cansat-tsniimash/NeonBlade-2024/README.md

# NeonBlade-2024
Это репозиторий команды Neon Blade
