cansat-tsniimash/NeonBlade-2024/docs/Зимняя сессия/Структурная схема.pdf

# Схема подключений

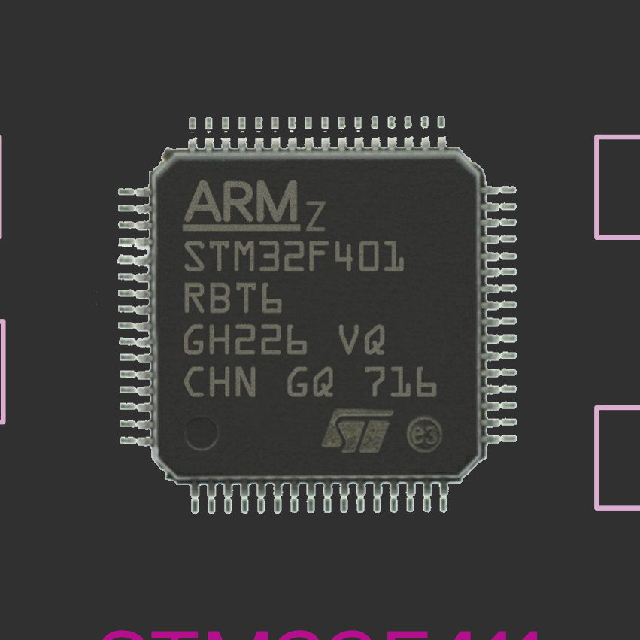
[picture p1: figure]

## STM32F411

SPI | SPI

BME280

LSM6DSL

LIS3MDL

## SPI

## SPI

ADC | UART
SDIO | SDIO

## GPIO

## ADC

ФОТОРЕЗИСТОР

GPIO | GPIO

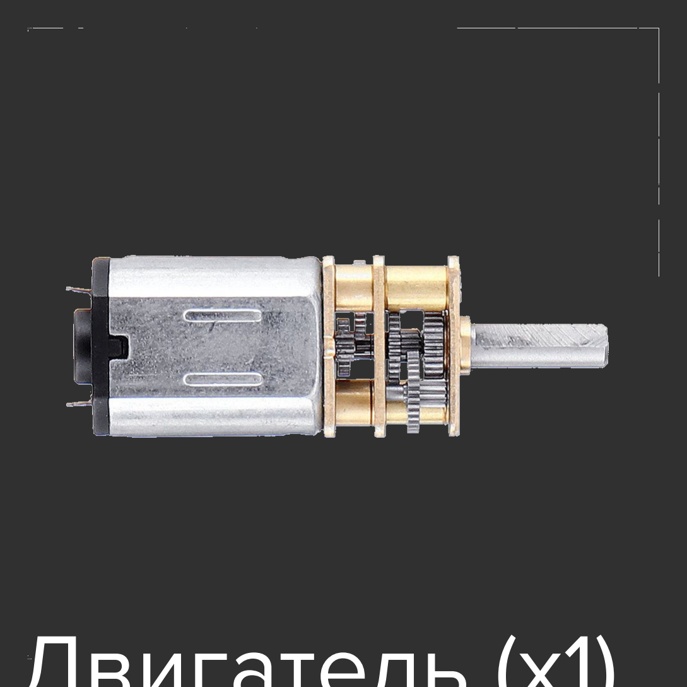
[picture p2: figure]

Двигатель (x1) | BUZZER

## GPIO

Усилитель

## UART

NEO-6M

microSD

TDC-GP21

## SPI

## SPI

NRF24L01

## SPI

## SPI

20
