cansat-tsniimash/NeonBlade-2024/docs/Зимняя сессия/Алгоритм работы.pdf

# Алгоритм работы

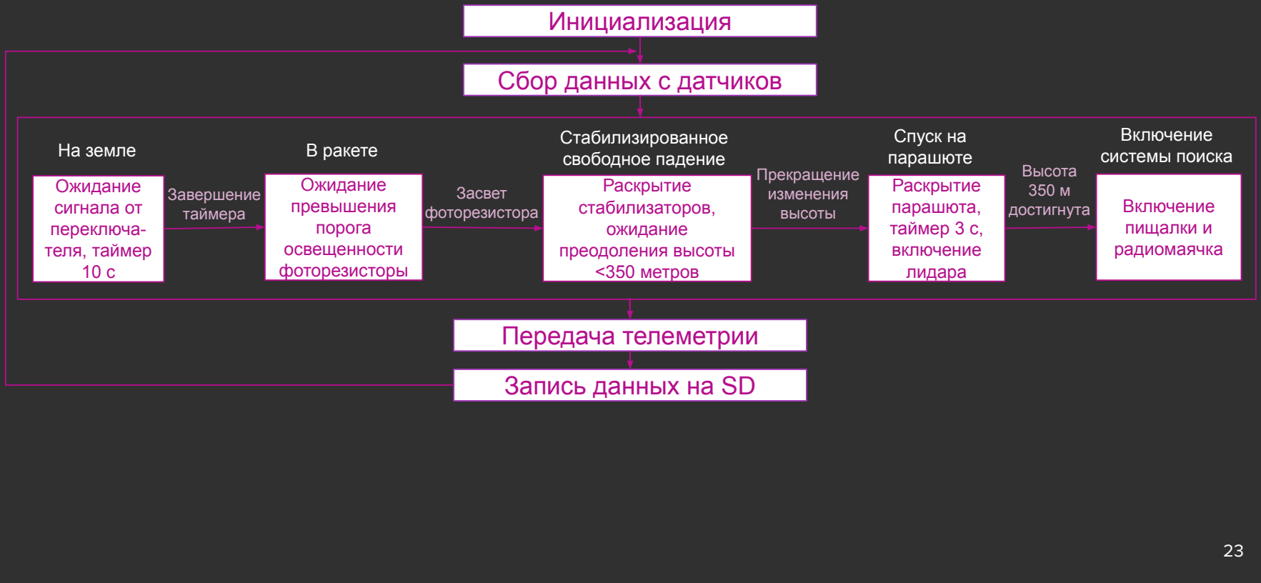
[picture p3: figure]
Инициализация; Сбор данных с датчиков; Ожидание сигнала от переключа- теля, таймер 10 с; На земле; Ожидание превышения порога освещенности фоторезисторы; В ракете; Раскрытие стабилизаторов, ожидание преодоления высоты <350 метров; Стабилизированное свободное падение; Раскрытие парашюта, таймер 3 с, включение лидара; Спуск на парашюте; Включение пищалки и радиомаячка; Включение системы поиска; Завершение таймера; Засвет фоторезистора; Высота 350 м достигнута; Прекращение изменения высоты; Передача телеметрии; Запись данных на SD
