cansat-tsniimash/NeonBlade-2024/docs/Зимняя сессия/Расчет парашюта.pdf

# Расчет парашюта

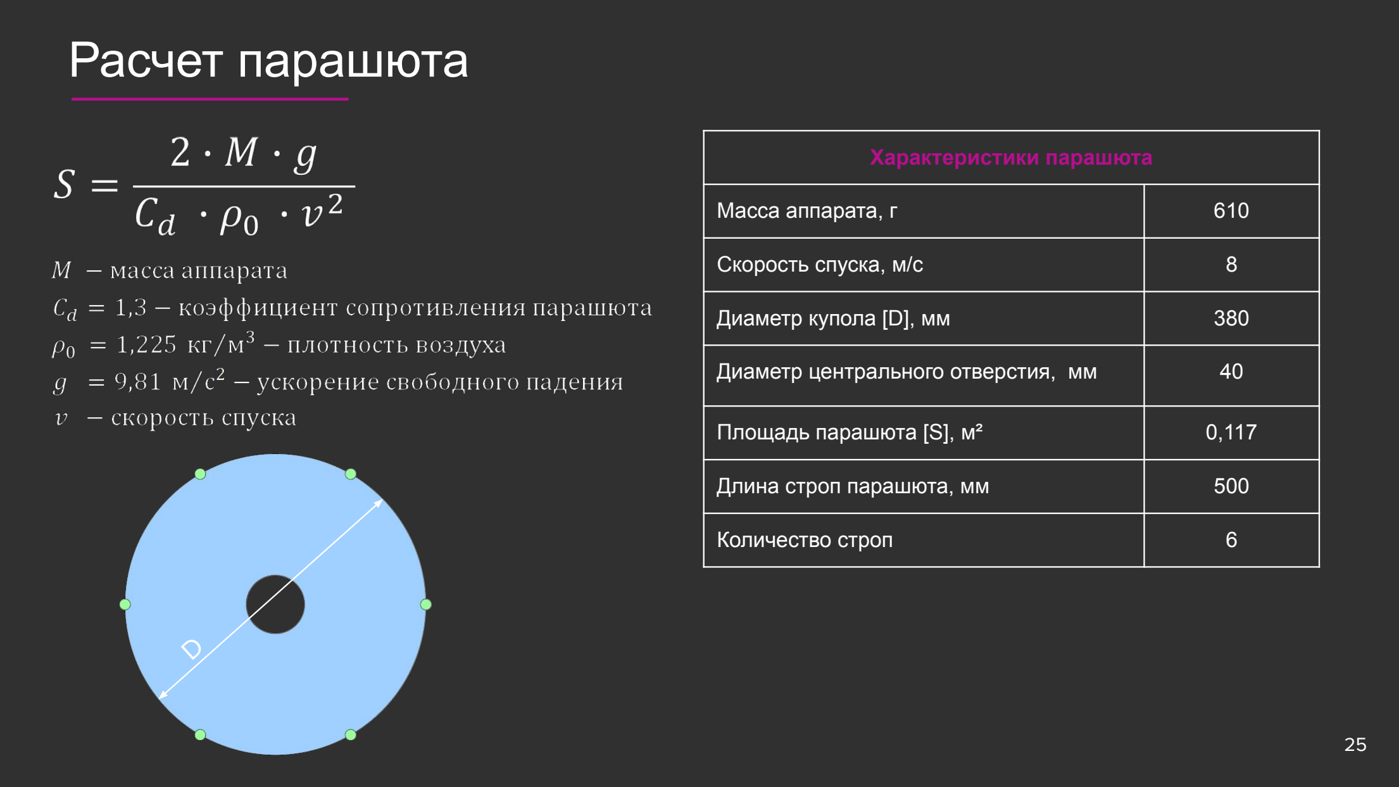
[picture p4: page 1]

D

Характеристики парашюта

Масса аппарата, г | 610
Скорость спуска, м/с | 8
Диаметр купола [D], мм | 380
Диаметр центрального отверстия, мм | 40
Площадь парашюта [S], м² | 0,117
Длина строп парашюта, мм | 500
Количество строп | 6

25
