cansat-tsniimash/NeonBlade-2024/construction/STLs/reika.stl

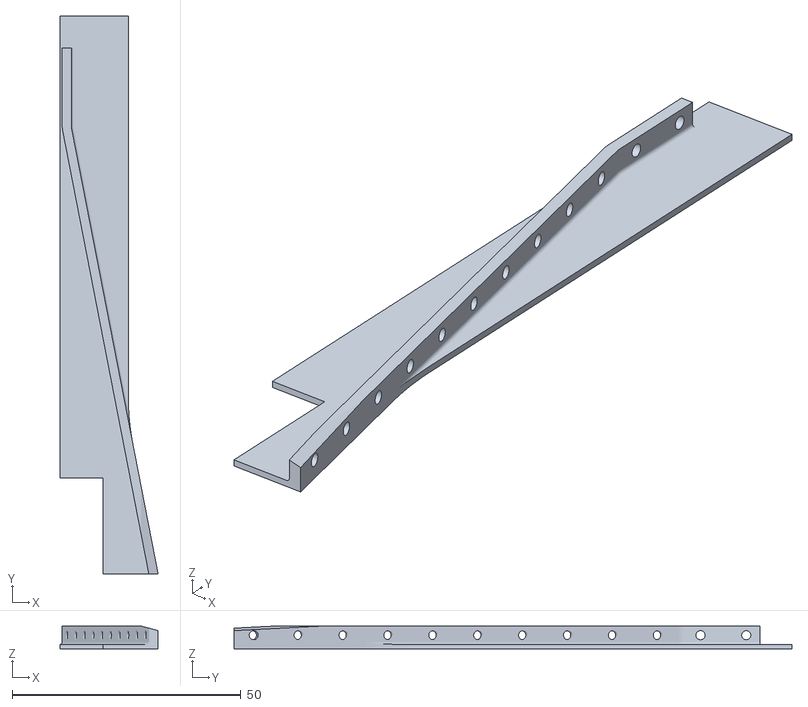
[picture p5: CAD file, 2024-05-11]
construction/STLs/reika.stl
21.5 x 122.0 x 5.00
