cansat-tsniimash/NeonBlade-2024/schematic/DXFs/board-lidar.dxf

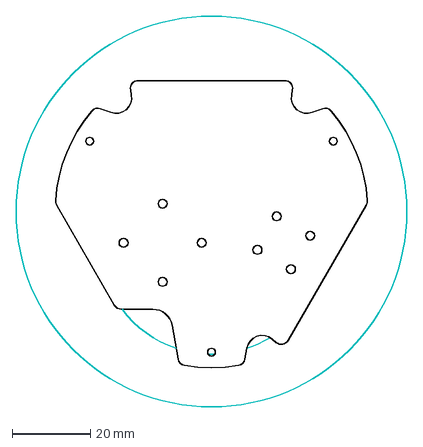
[picture p6: CAD file, 2024-03-04]
schematic/DXFs/board-lidar.dxf
100.0 x 100.0 mm
