cansat-tsniimash/NeonBlade-2024/src/ground/laptop/lowmodulesborkalast.stl

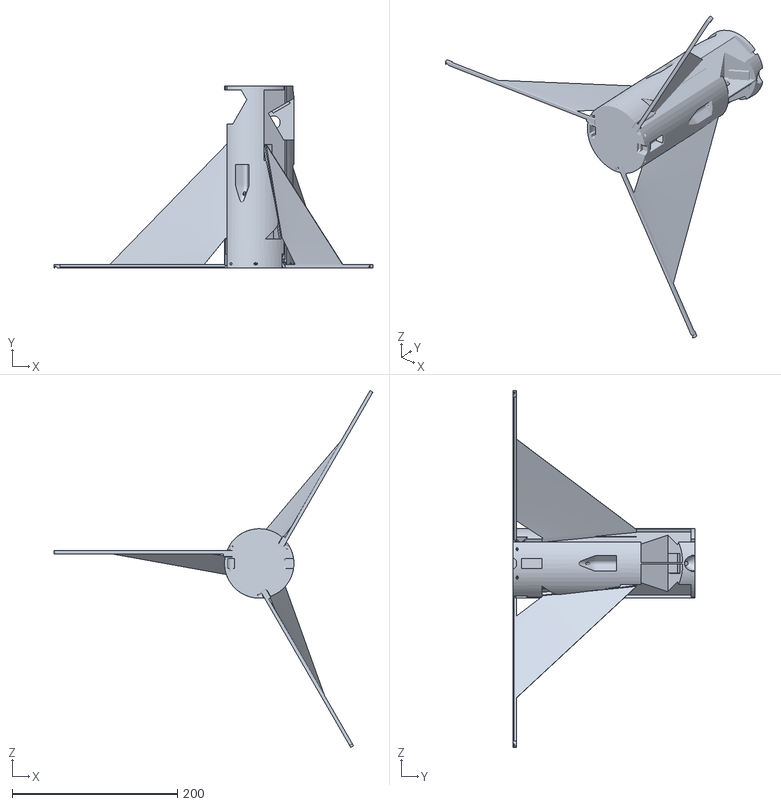
[picture p7: CAD file, 2024-04-19]
src/ground/laptop/lowmodulesborkalast.stl
385.8 x 220.0 x 432.0
