cansat-tsniimash/NeonBlade-2024/construction/STLs/protective-tip-big.stl

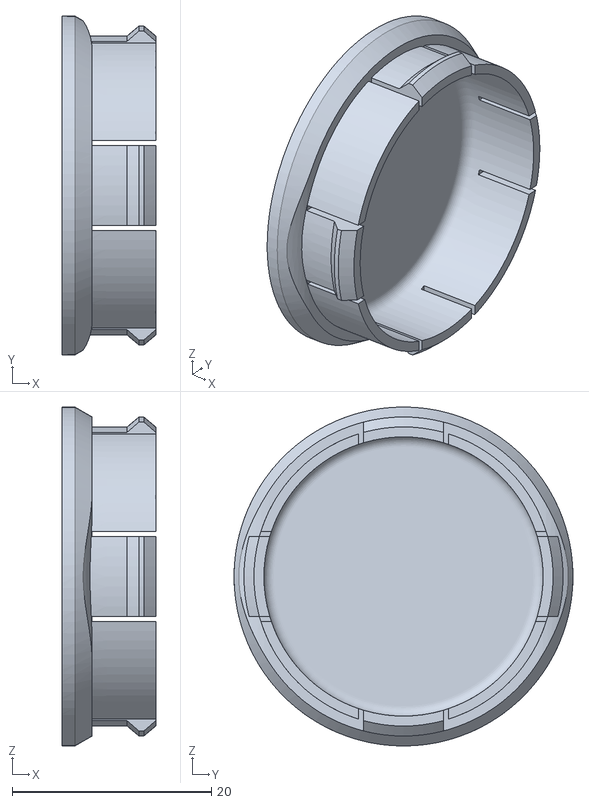
[picture p8: CAD file, 2024-05-11]
construction/STLs/protective-tip-big.stl
9.38 x 34.0 x 34.0
