cansat-tsniimash/NeonBlade-2024/schematic/DXFs/board-bottom.dxf

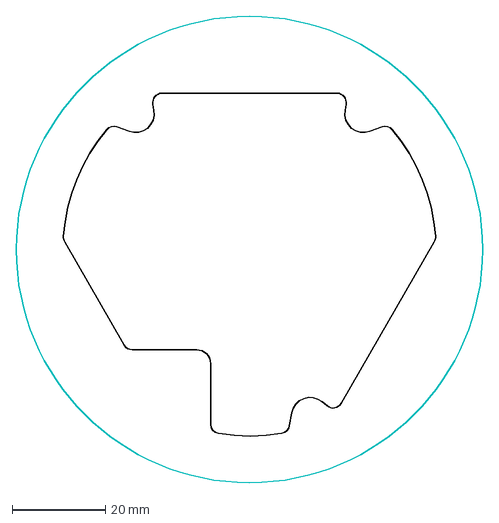
[picture p9: CAD file, 2024-03-04]
schematic/DXFs/board-bottom.dxf
100.0 x 100.0 mm
