cansat-tsniimash/NeonBlade-2024/construction/STLs/stergni.stl

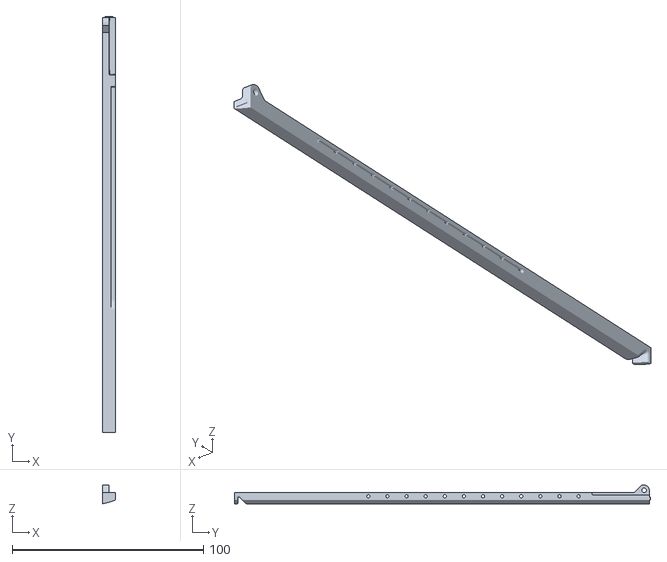
[picture p10: CAD file, 2024-05-11]
construction/STLs/stergni.stl
7.00 x 217.6 x 9.85
