cansat-tsniimash/NeonBlade-2024/schematic/DXFs/board-top.dxf

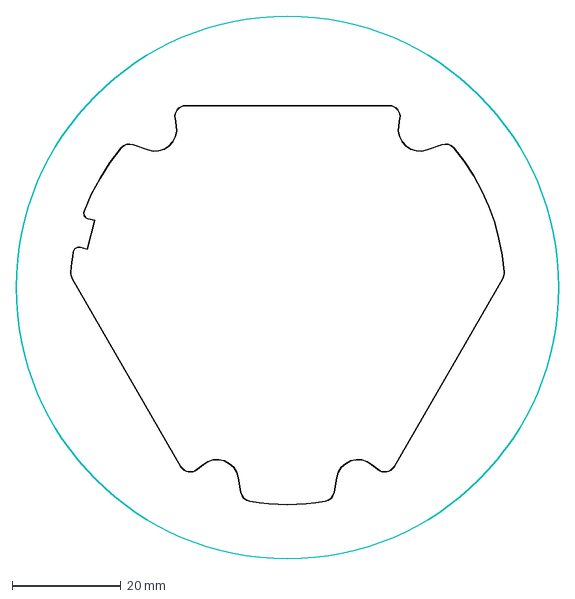
[picture p11: CAD file, 2024-03-04]
schematic/DXFs/board-top.dxf
100.0 x 100.0 mm
