cansat-tsniimash/NeonBlade-2024/src/ground/laptop/test3dmesh.stl

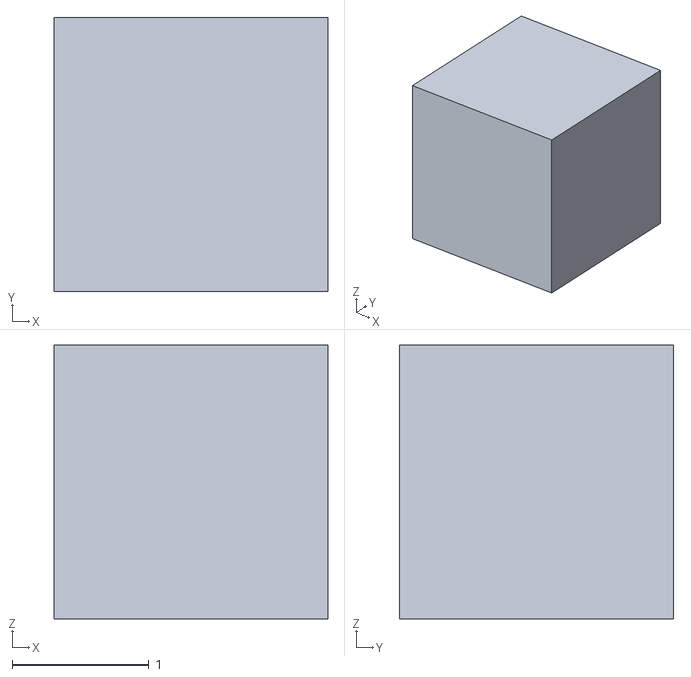
[picture p12: CAD file, 2024-04-19]
src/ground/laptop/test3dmesh.stl
2.00 x 2.00 x 2.00
