cansat-tsniimash/NeonBlade-2024/construction/STLs/parachute-cap.stl

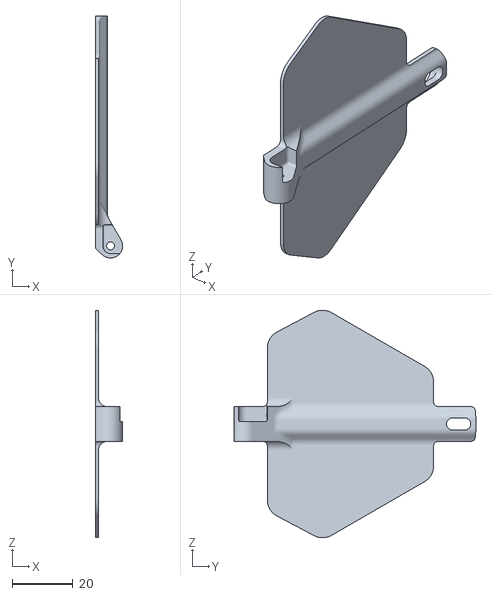
[picture p13: CAD file, 2024-05-11]
construction/STLs/parachute-cap.stl
9.00 x 80.0 x 75.2
