cansat-tsniimash/NeonBlade-2024/schematic/DXFs/plata_verx.dxf

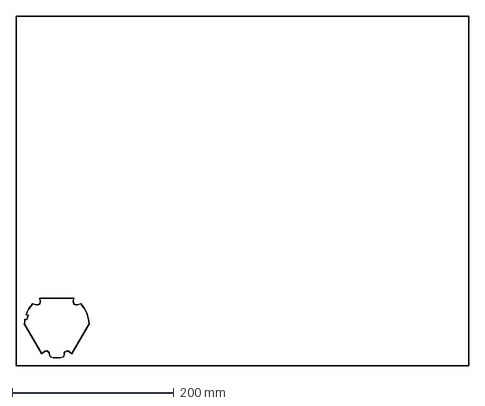
[picture p14: CAD file, 2024-02-07]
schematic/DXFs/plata_verx.dxf
558.8 x 431.8 mm
