cansat-tsniimash/NeonBlade-2024/src/ground/laptop/Sat_Simple2.stl

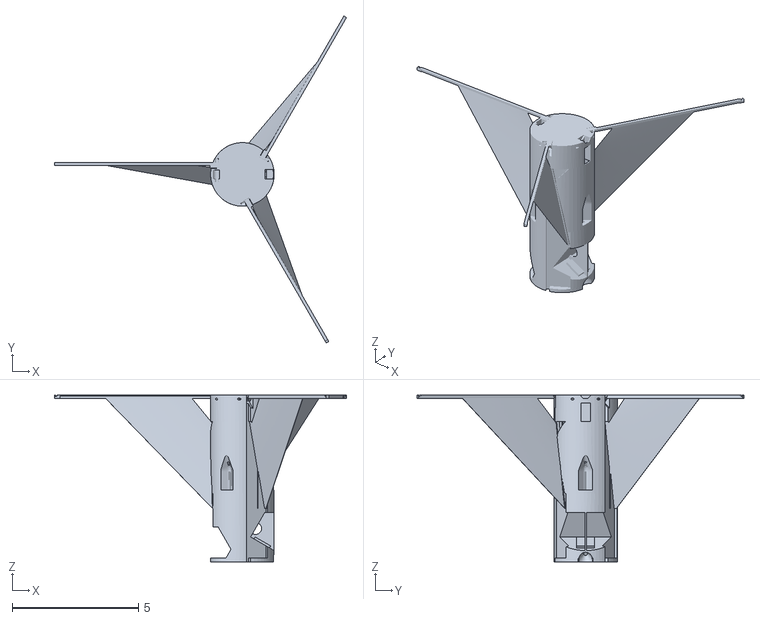
[picture p15: CAD file, 2024-04-19]
src/ground/laptop/Sat_Simple2.stl
11.6 x 13.0 x 6.60
