cansat-tsniimash/NeonBlade-2024/construction/STLs/parashute-korpus.stl

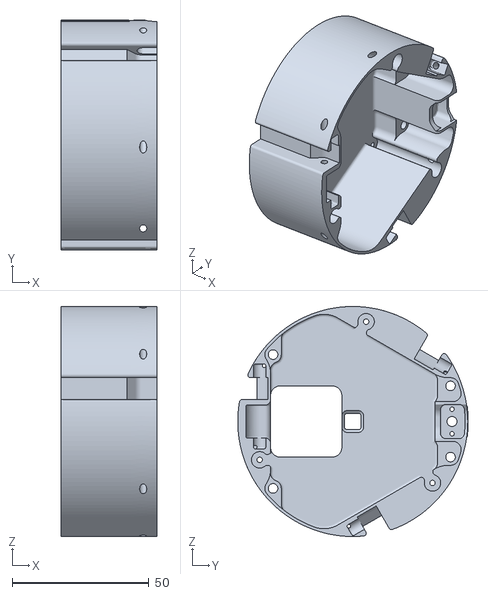
[picture p16: CAD file, 2024-05-11]
construction/STLs/parashute-korpus.stl
35.0 x 84.2 x 84.0
