cansat-tsniimash/NeonBlade-2024/schematic/DXFs/plata-lidarna.dxf

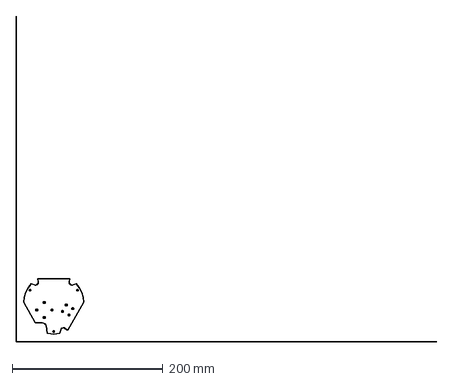
[picture p17: CAD file, 2024-02-07]
schematic/DXFs/plata-lidarna.dxf
558.8 x 431.8 mm
