cansat-tsniimash/NeonBlade-2024/construction/STLs/korpus-top.stl

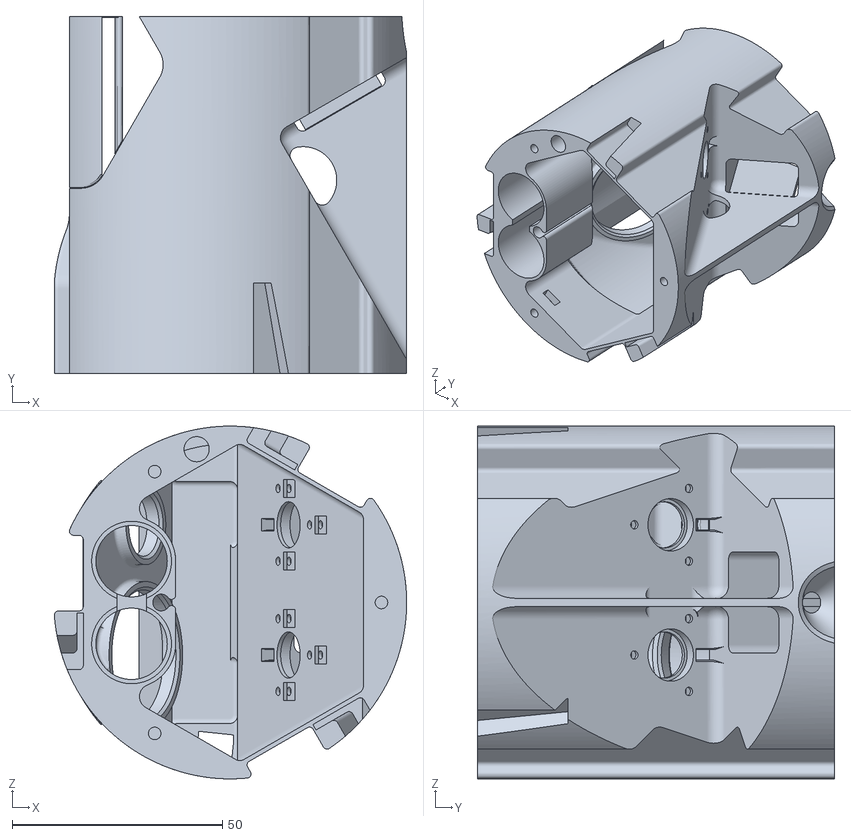
[picture p18: CAD file, 2024-05-11]
construction/STLs/korpus-top.stl
83.9 x 85.0 x 84.0
