cansat-tsniimash/NeonBlade-2024/construction/STLs/korpus-botom.stl

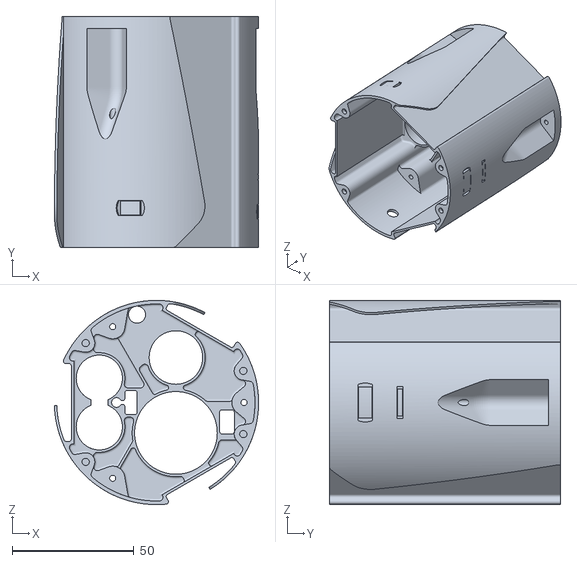
[picture p19: CAD file, 2024-05-11]
construction/STLs/korpus-botom.stl
84.0 x 95.0 x 84.0
