cansat-tsniimash/NeonBlade-2024/construction/STLs/incinerator-korpus.stl

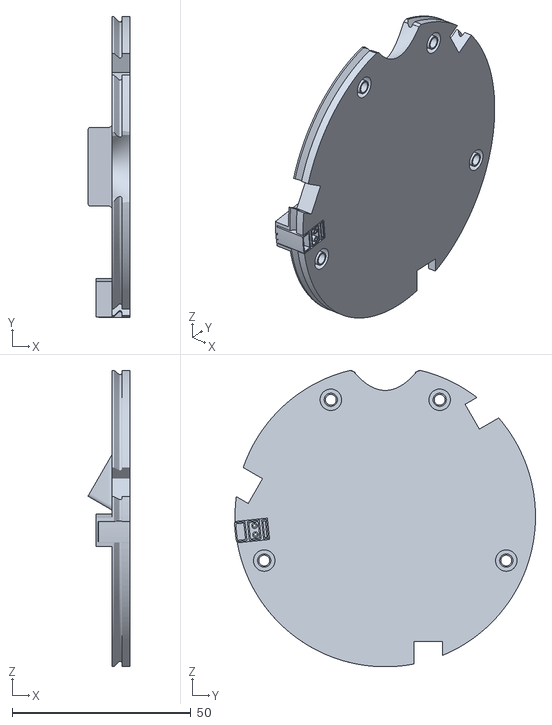
[picture p20: CAD file, 2024-05-11]
construction/STLs/incinerator-korpus.stl
11.8 x 84.1 x 82.9
