cansat-tsniimash/NeonBlade-2024/construction/STLs/mirrorholder1.stl

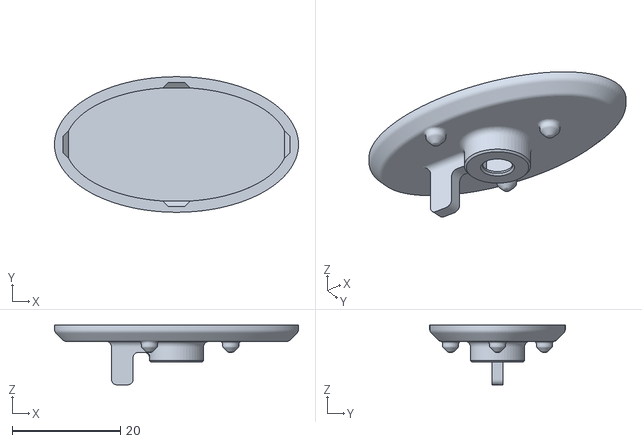
[picture p21: CAD file, 2024-05-11]
construction/STLs/mirrorholder1.stl
45.0 x 25.0 x 11.0
