cansat-tsniimash/NeonBlade-2024/construction/STLs/mirrorholder2.stl

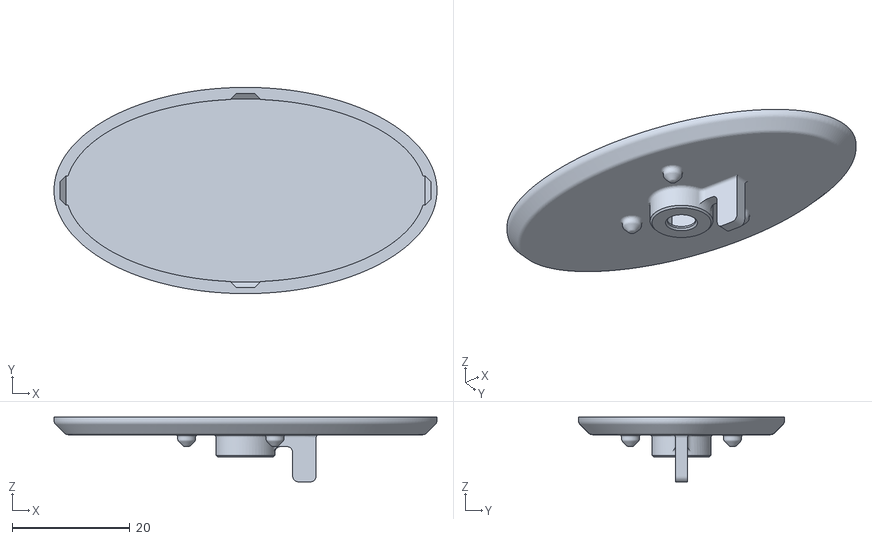
[picture p22: CAD file, 2024-05-11]
construction/STLs/mirrorholder2.stl
65.0 x 35.0 x 11.0
