cansat-tsniimash/NeonBlade-2024/construction/STLs/protective-tip-small.stl

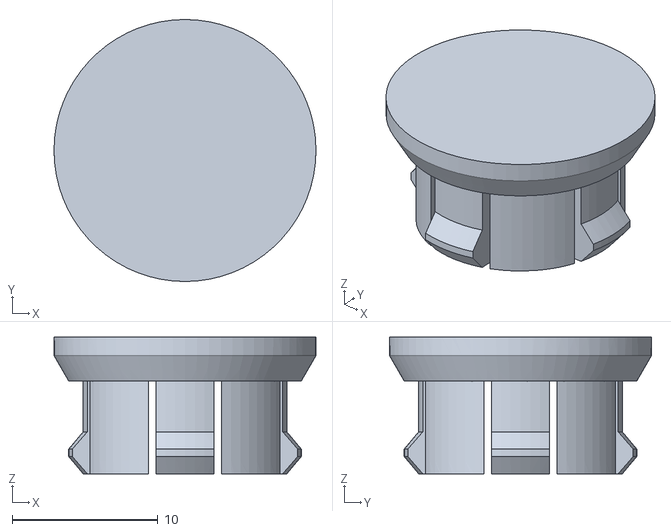
[picture p23: CAD file, 2024-05-11]
construction/STLs/protective-tip-small.stl
18.0 x 18.0 x 9.38
