cansat-tsniimash/NeonBlade-2024/construction/STLs/parashute-platform.stl

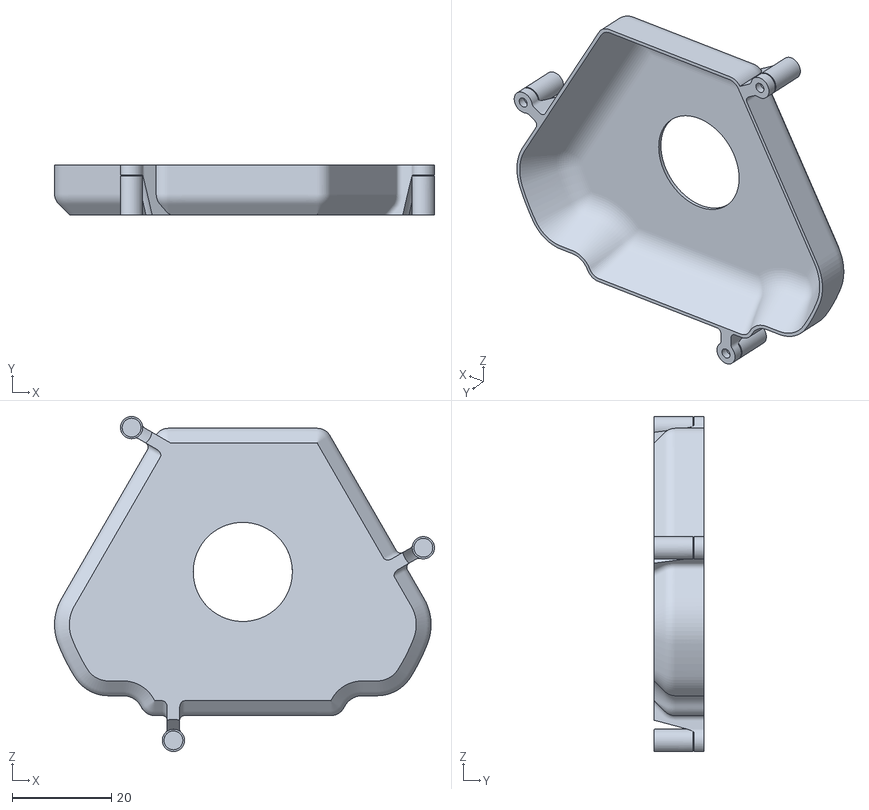
[picture p24: CAD file, 2024-05-11]
construction/STLs/parashute-platform.stl
76.7 x 10.0 x 67.6
