cansat-tsniimash/NeonBlade-2024/construction/STLs/kranshtein.stl

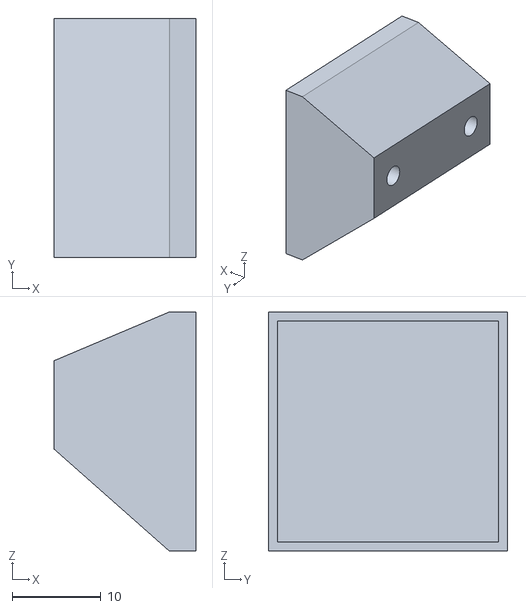
[picture p25: CAD file, 2024-05-08]
construction/STLs/kranshtein.stl
16.0 x 27.0 x 27.0
