cansat-tsniimash/NeonBlade-2024/construction/STLs/mockup_banka.stl

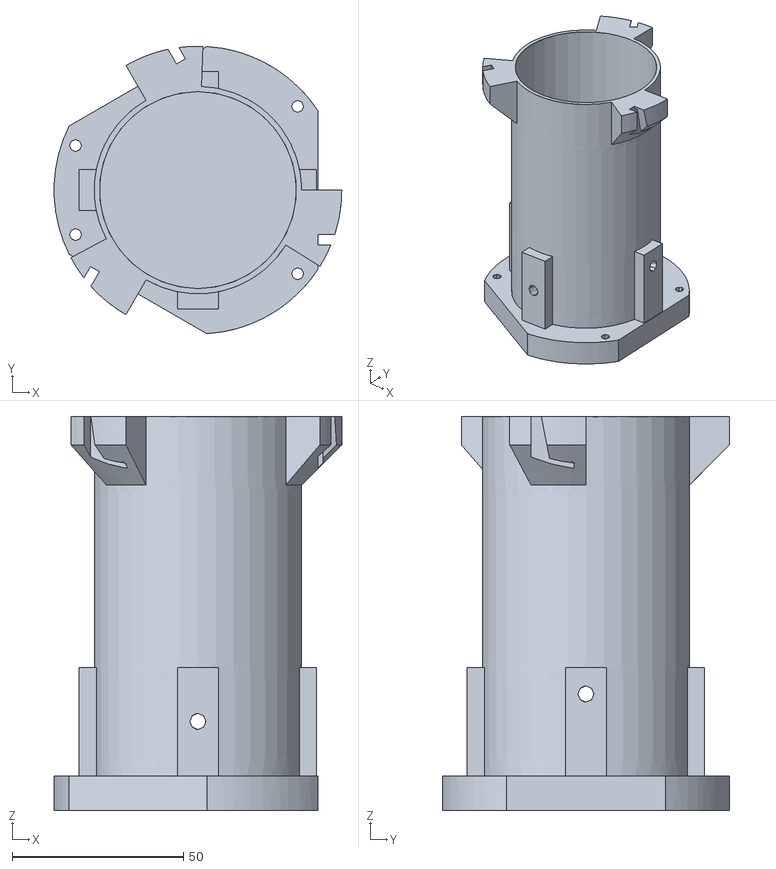
[picture p26: CAD file, 2024-04-19]
construction/STLs/mockup_banka.stl
83.9 x 83.9 x 115.0
