cansat-tsniimash/NeonBlade-2024/(list of files, cad)

Other CAD files:
src/ground/laptop/sat_simple.stl
construction/sat-mockup/axe.prt
construction/sat-mockup/mockup_banka.prt
construction/sat-mockup/parachute-cap.prt
construction/sat-mockup/parashute-korpus.prt
construction/sat-mockup/parashute-platform.prt
construction/sat-mockup/real_banka.prt
construction/sat-mockup/spring.prt
construction/sat-mockup/spring_0_8x4x9turns.prt
construction/sat/antena_gabena.prt
construction/sat/axe.prt
construction/sat/bme280_module.prt
construction/sat/board-bottom.prt
construction/sat/board-lidar.prt
construction/sat/board-top.prt
construction/sat/buzzer.prt
construction/sat/connector-pbs.prt
construction/sat/connector_b2b-eh-a.prt
construction/sat/connector_pbs-smd.prt
construction/sat/connector_pls-smd.prt
construction/sat/dc_dc.prt
construction/sat/fotorez.prt
construction/sat/gps_antenna.prt
construction/sat/gps_ublox_neo-7m-0-000.prt
construction/sat/gpstwo.prt
construction/sat/gy-lsm6ds3_lsm6ds3.prt
construction/sat/incinerator-holder.prt
construction/sat/incinerator-korpus.prt
construction/sat/kamushkin.prt
construction/sat/key.prt
construction/sat/korpus-botom.prt
construction/sat/korpus-top.prt
construction/sat/kranshtein.prt
construction/sat/lens1.prt
construction/sat/lens2.prt
construction/sat/lenshildersmallprt2.prt
construction/sat/lensholder.prt
construction/sat/lensholder2.prt
construction/sat/lensholderbig.prt
construction/sat/lensholderbigprt2.prt
construction/sat/lensholdersmall.prt
construction/sat/li-ion-cell_icr18650-1400.prt
construction/sat/magnetometer_lis3mdl.prt
construction/sat/microsd_connector_502774-0891.prt
construction/sat/mirror1.prt
construction/sat/mirror2.prt
construction/sat/mirrorholder1.prt
construction/sat/mirrorholder2.prt
construction/sat/motor-reductor.prt
construction/sat/mtapd-07-013.prt
construction/sat/nrf24l01_pa_lna_e01_ml01sp4.prt
construction/sat/parachute-cap.prt
construction/sat/parashute-korpus.prt
construction/sat/parashute-platform.prt
construction/sat/pinhead_smd_female.prt
construction/sat/pinhead_smd_male.prt
construction/sat/protective-tip-big.prt
construction/sat/protective-tip-small.prt
construction/sat/reika.prt
construction/sat/rope.prt
construction/sat/spherical_bearing.prt
construction/sat/spl_pl90_3.prt
construction/sat/spring_0_8x4x9turns.prt
construction/sat/stabilizator.prt
construction/sat/stergni.prt
construction/sat/stm32_plate.prt
construction/sat/svetasolar.prt
construction/sat/switch_mss-12d01.prt
construction/sat/switch_ss-12d10.prt
construction/sat/switch_ss-12d11.prt
construction/sat/vint_g11738_2.prt
construction/sat/xq_02a_usilitel.prt
construction/sat_simple/axe.prt
construction/sat_simple/camera-sq11.prt
construction/sat_simple/holder_for_jew.prt
construction/sat_simple/jew.prt
construction/sat_simple/low_module_carcas-v2.prt
construction/sat_simple/low_module_prt1.prt
construction/sat_simple/mirror1.prt
construction/sat_simple/mirror2.prt
construction/sat_simple/mirrorholder1.prt
construction/sat_simple/mirrorholder2.prt
construction/sat_simple/motor-reductor.prt
construction/sat_simple/parachutecap.prt
construction/sat_simple/parashute_platform.prt
construction/sat_simple/protective-tip-big.prt
construction/sat_simple/protective-tip-small.prt
construction/sat_simple/reika.prt
construction/sat_simple/rope.prt
construction/sat_simple/shadowraze.prt
construction/sat_simple/spherical_bearing.prt
construction/sat_simple/spring.prt
construction/sat_simple/spring_0_8x4x9turns.prt
construction/sat_simple/stabilizator.prt
construction/sat_simple/stergni.prt
schematic/DXFs/board_bottom.dxf
