cansat-tsniimash/NeonBlade-2024/docs/Зимняя сессия/NB.0000-0ГЧ Габаритный чертеж.pdf

Б

А

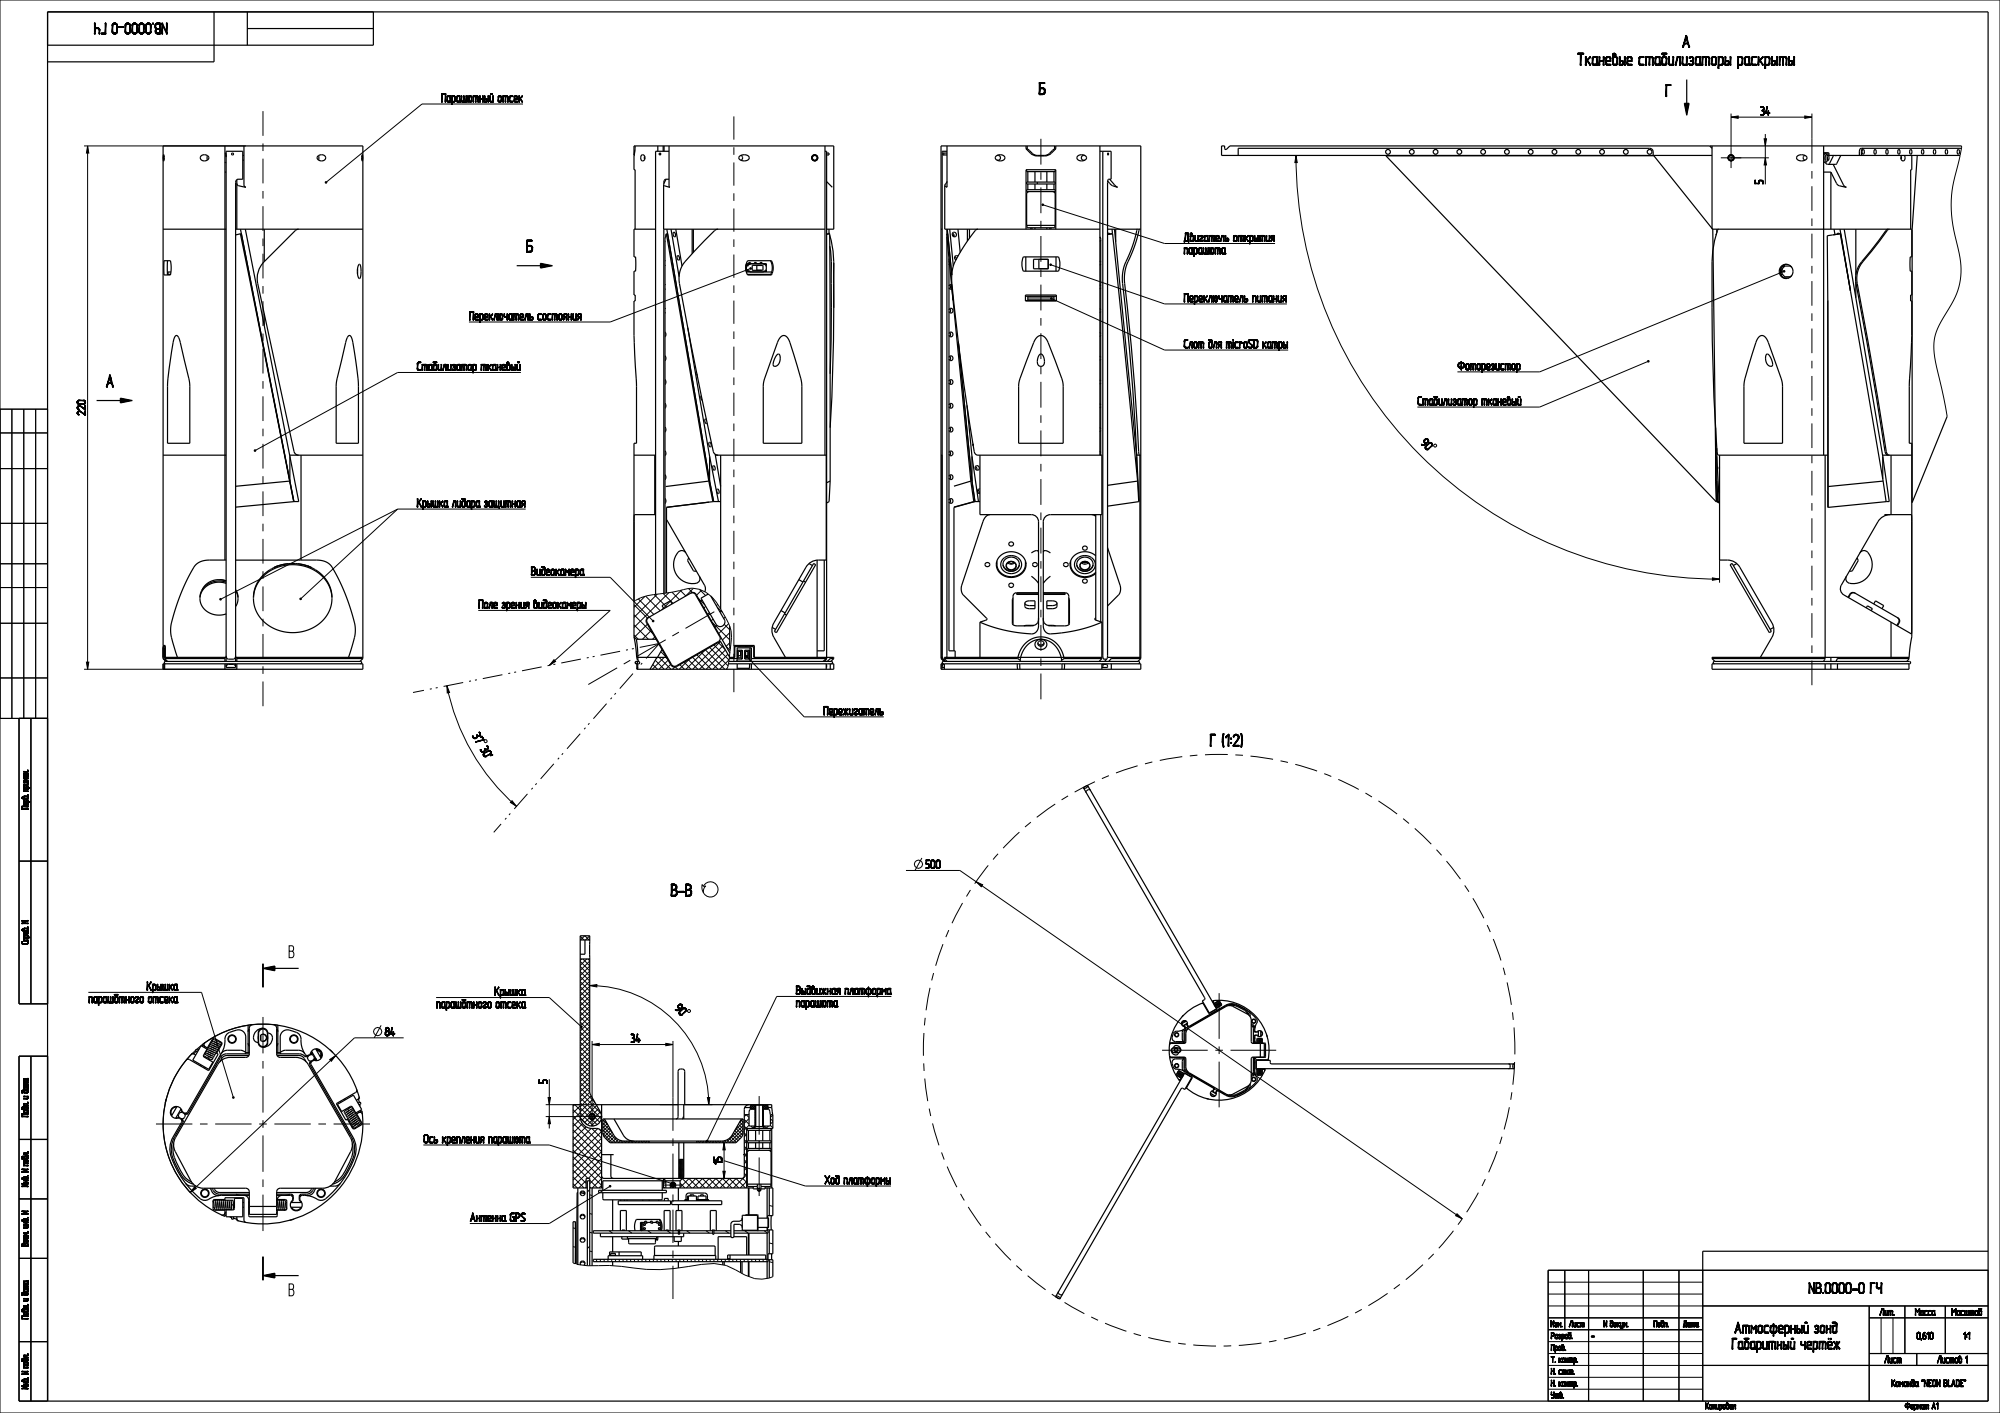
[picture p27: page 1]
Êîïèðîâàë; Ôîðìàò À1; Атмосферный зонд Габаритный чертёж; Ëèò.; Ìàññà; Ìàñøòàá; Èçì.; Ëèñò; N äîêóì.; Ïîäï.; Äàòà; Ðàçðàá.; Ïðîâ.; Ò. êîíòð.; Í. ñåêò.; Í. êîíòð.; Команда "NEON BLADE"; Óòâ.; Стабилизатор тканевый; Парашютный отсек; Видеокамера; Пережигатель; Переключатель состояния; Крышка; парашбтного отсека; Фоторезистор; Выдвижная платформа парашюта; Антенна GPS; Ход платформы; Переключатель питания; Двигатель открытия парашюта; Ëèñòîâ 1

Тканевые стабилизаторы раскрыты

Слот для microSD катры

Крышка лидара защитная

Поле зрения видеокамеры

Èíâ. N ïîäë. Ïîäï. è äàòà Âçàì. èíâ. N Èíâ. N ïîäë. Ïîäï. è äàòà Ñïðàâ. N Ïåðâ. ïðèìåí.

Ось крепления парашюта
