cansat-tsniimash/NeonBlade-2024/schematic/board/lidar_made_by_apple.brd

## EAGLE design schematic/board/lidar_made_by_apple.brd (2024-05-12)

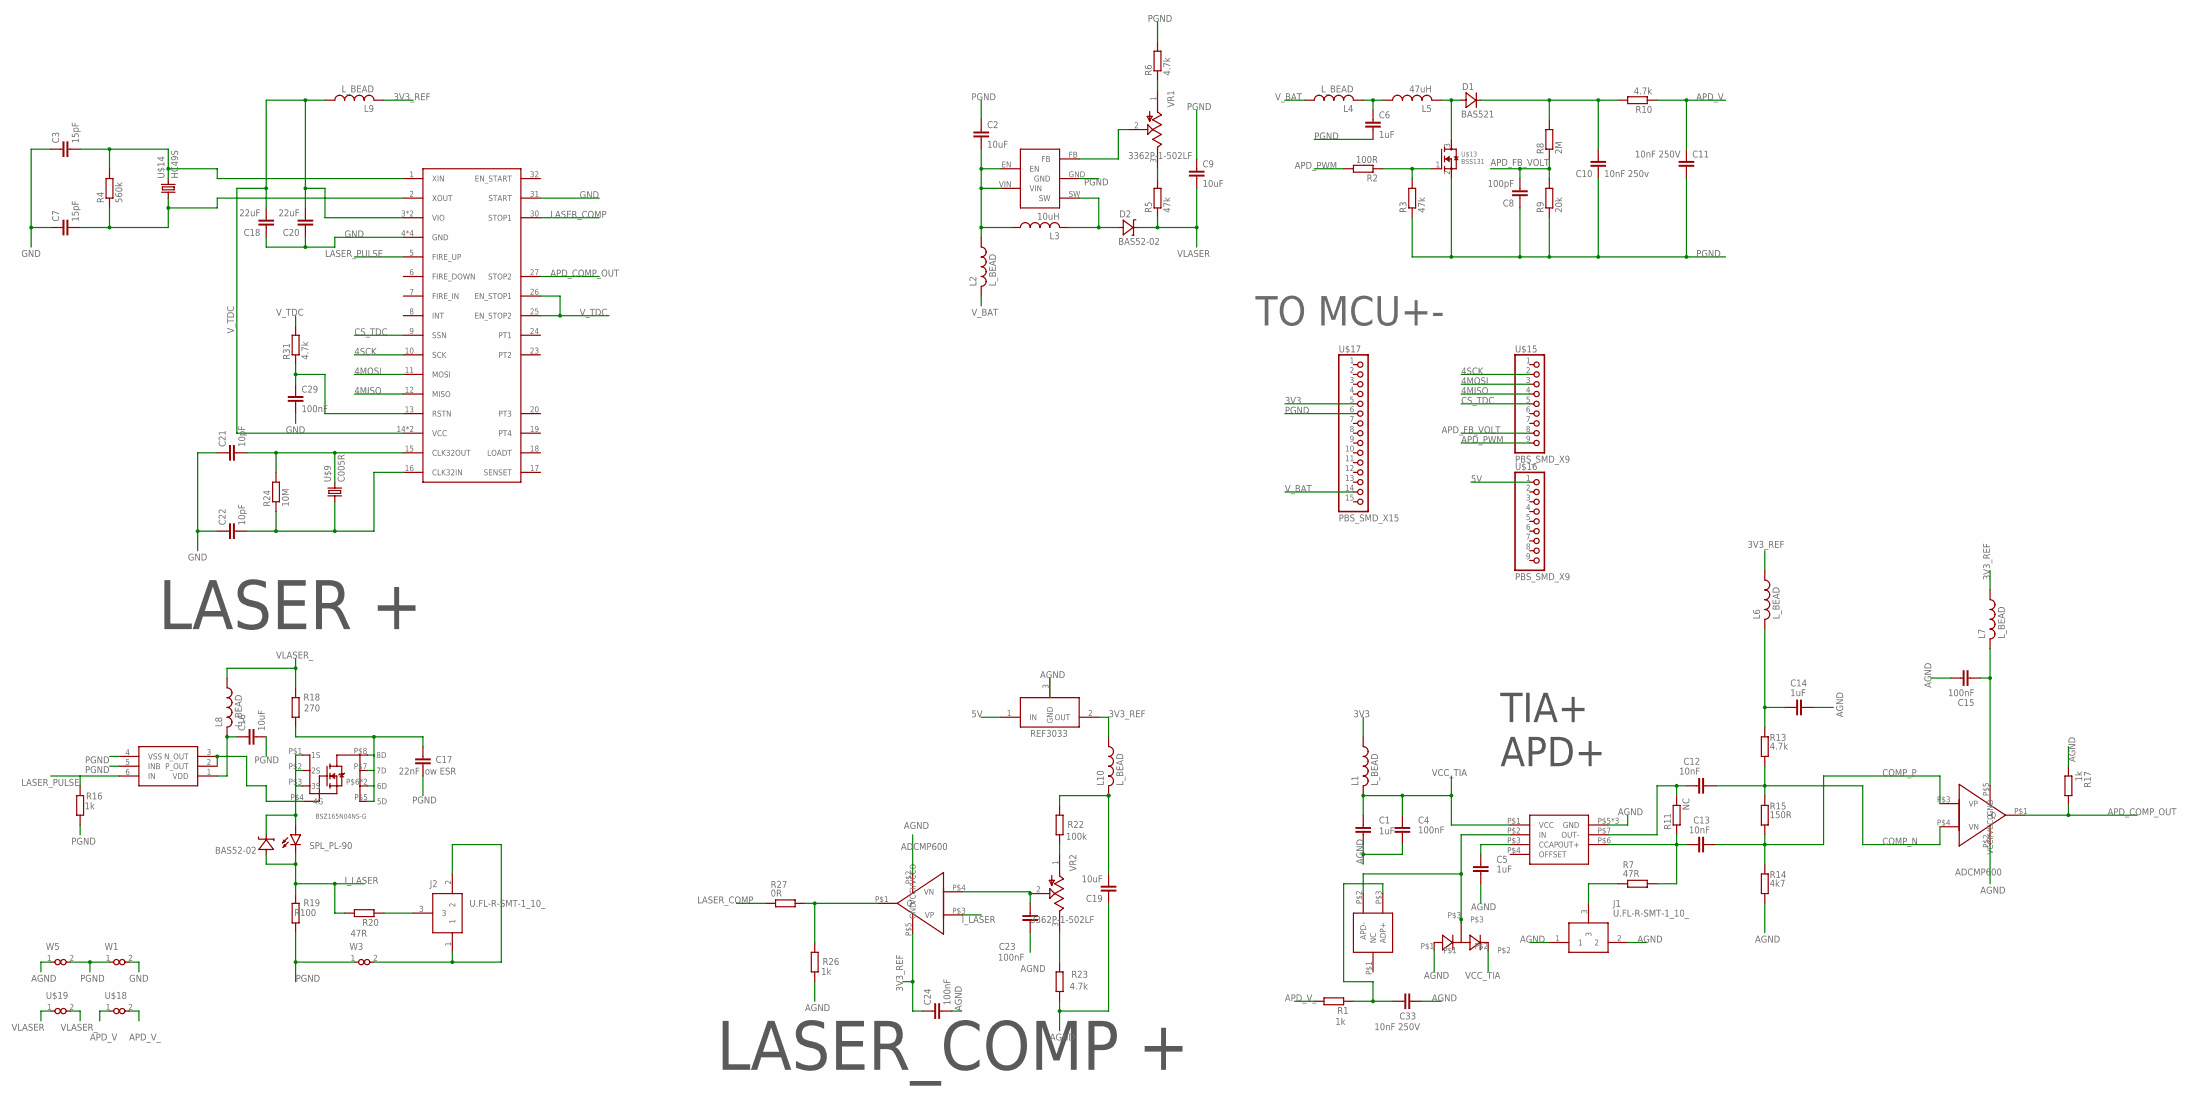
[picture p28: schematic lidar_made_by_apple.sch]

Parts:
C1, C5, C6, C14: 1uF; C0603
C2, C9, C16, C19: 10uF; C1206
C3, C7: 15pF; C0603
C4, C15, C23, C24, C29: 100nF; C0603
C8: 100pF; C0603
C10: 10nF 250v; C0805
C11, C33: 10nF 250V; C0805
C12, C13: 10nF; C0603
C17: 22nF low ESR; C0603
C18, C20: 22uF; C1206
C21, C22: 10pF; C0603
D1: BAS521; SOD523
D2: BAS52-02; SOD523
D6: BAV99
J1, J2: U.FL-R-SMT-1_10_; U.FL-R-SMT-1(10)
L1, L2, L4, L6, L7, L8, L9, L10: L_BEAD
L3: 10uH; L_12X12
L5: 47uH; 1210
R1, R16, R17, R26: 1k; R0603
R2: 100R; R0603
R3, R5: 47k; R0603
R4: 560k; R0603
R6, R10, R13, R23, R31: 4.7k; R0603
R7, R20: 47R; R0603
R8: 2M; R0603
R9: 20k; R0603
R11: NC; R0603
R14: 4k7; R0603
R15: 150R; R0603
R18: 270; R0603
R19: R100; R2512
R22: 100k; R0603
R24: 10M; R0603
R27: 0R; R0603
REF3033: REF3033; SOT23-3
U$2: BSZ165N04NS-G
U$3: BAS52-02; SOD523
U$4, U$8: ADCMP600
U$5: MAX40658-8-TDFN-3X3MM
U$6: SPL_PL-90
U$7: MTAPD-07-013; MAPD-07-013
U$9: C005R
U$10: TDC-GP21
U$11: MIC2288
U$12: LM5114; SOT23-6
U$13: BSS131; SOT23-3
U$14: HC49S
U$15, U$16: PBS_SMD_X9
U$17: PBS_SMD_X15; PBD_SMD_X15
U$18, U$19: VIAS-CONNECT
VR1, VR2: 3362P-1-502LF; TRIM_3362P-1-502LF
W1, W3, W5: VIAS-CONNECT

Connections:
3V3: L1.1, U$17.5
3V3_REF: C24.1, L6.1, L7.1, L9.2, L10.1, REF3033.2 (OUT), U$4.P$5 (VCCI/VCCO)
4MISO: U$10.12 (MISO), U$15.4
4MOSI: U$10.11 (MOSI), U$15.3
4SCK: U$10.10 (SCK), U$15.2
5V: REF3033.1 (IN), U$16.1
AGND: C1.2, C4.2, C5.2, C14.1, C15.1, C19.1, C23.2, C24.2, C33.2, D6.P$1, J1.1, J1.2, R14.2, R17.1, R23.1, R26.1, REF3033.3 (GND), U$4.P$2 (GND), U$5.P$5 (GND), U$5.P$8 (GND), U$5.P$9 (GND), U$8.P$2 (GND), W5.1
APD_COMP_OUT: R17.2, U$8.P$1 (Q), U$10.27 (STOP2)
APD_FB_VOLT: C8.2, R8.1, R9.2, U$15.8
APD_PWM: R2.2, U$15.9
APD_V: C11.2, R10.1, U$18.1
APD_V_: R1.2, U$18.2
COMP_N: C12.2, R13.2, R15.1, U$8.P$4 (VN)
COMP_P: C13.2, R14.1, R15.2, U$8.P$3 (VP)
CS_TDC: U$10.9 (SSN), U$15.5
GND: C3.1, C7.1, C18.1, C20.1, C21.1, C22.1, C29.2, U$10.4 (GND), U$10.21 (GND), U$10.28 (GND), U$10.31 (START), U$10.P$1 (GND), W1.2
I_LASER: R19.2, R20.2, U$3.P$2 (A), U$4.P$3 (VP), U$6.P$2 (C)
LASER_COMP: R27.1, U$10.30 (STOP1)
LASER_PULSE: R16.2, U$10.5 (FIRE_UP), U$12.6 (IN)
unnamed: U$2.P$4 (4G), U$12.2 (P_OUT), U$12.3 (N_OUT)
unnamed: C16.1, L8.2, U$12.1 (VDD)
unnamed: C17.2, R18.1, U$2.P$5 (5D), U$2.P$6 (6D), U$2.P$7 (7D), U$2.P$8 (8D), U$2.P$9 (6D)
unnamed: U$2.P$1 (1S), U$2.P$2 (2S), U$2.P$3 (3S), U$3.P$1 (C), U$6.P$1 (A)
unnamed: C23.1, U$4.P$4 (VN), VR2.2 (WIPER)
unnamed: C19.2, L10.2, R22.2
unnamed: D6.P$3, U$5.P$2 (IN), U$7.P$2 (APD-)
unnamed: C5.1, U$5.P$3 (CCAP)
unnamed: C12.1, R11.2, U$5.P$7 (OUT-)
unnamed: C13.1, R7.2, R11.1, U$5.P$6 (OUT+)
unnamed: J1.3, R7.1
unnamed: C33.1, R1.1, U$7.P$3 (ADP+)
unnamed: C14.2, L6.2, R13.1
unnamed: C15.2, L7.2, U$8.P$5 (VCCI/VCCO)
unnamed: J2.3, R20.1
unnamed: R26.2, R27.2, U$4.P$1 (Q)
unnamed: J2.1, J2.2, W3.2
unnamed: C7.2, R4.1, U$10.2 (XOUT), U$14.P$1 (1)
unnamed: C29.1, R31.1, U$10.13 (RSTN)
unnamed: C2.2, L2.1, L3.P$1 (1), U$11.EN, U$11.VIN
unnamed: C21.2, R24.2, U$9.P$2 (2), U$10.15 (CLK32OUT)
unnamed: C3.2, R4.2, U$10.1 (XIN), U$14.P$2 (2)
unnamed: C22.2, R24.1, U$9.P$1 (1), U$10.16 (CLK32IN)
unnamed: D2.P$2 (A), L3.P$2 (2), U$11.SW
unnamed: U$11.FB, VR1.2 (WIPER)
unnamed: R2.1, R3.2, U$13.1 (G)
unnamed: D1.P$2 (2), L5.2, U$13.3 (D)
unnamed: C10.2, D1.P$1 (1), R8.2, R10.2
unnamed: R6.1, VR1.1 (CCW)
unnamed: R5.2, VR1.3 (CW)
unnamed: C6.1, L4.2, L5.1
unnamed: R22.1, VR2.1 (CCW)
unnamed: R23.2, VR2.3 (CW)
PGND: C2.1, C6.2, C8.1, C9.1, C10.1, C11.1, C16.2, C17.1, R3.1, R6.2, R9.1, R16.1, R19.1, U$11.GND, U$12.4 (VSS), U$12.5 (INB), U$13.2 (S), U$17.6, W1.1, W3.1, W5.2
VCC_TIA: C1.1, C4.1, D6.P$2, L1.2, U$5.P$1 (VCC)
VLASER: C9.2, D2.P$1 (C), R5.1, U$19.1
VLASER_: L8.1, R18.2, U$19.2
V_BAT: L2.2, L4.1, U$17.14
V_TDC: C18.2, C20.2, L9.1, R31.2, U$10.3 (VIO), U$10.14 (VCC), U$10.22 (VIO), U$10.25 (EN_STOP2), U$10.26 (EN_STOP1), U$10.29 (VCC)

Notes on the sheet:
TO MCU+-
LASER +
LASER_COMP +
TIA+ APD+

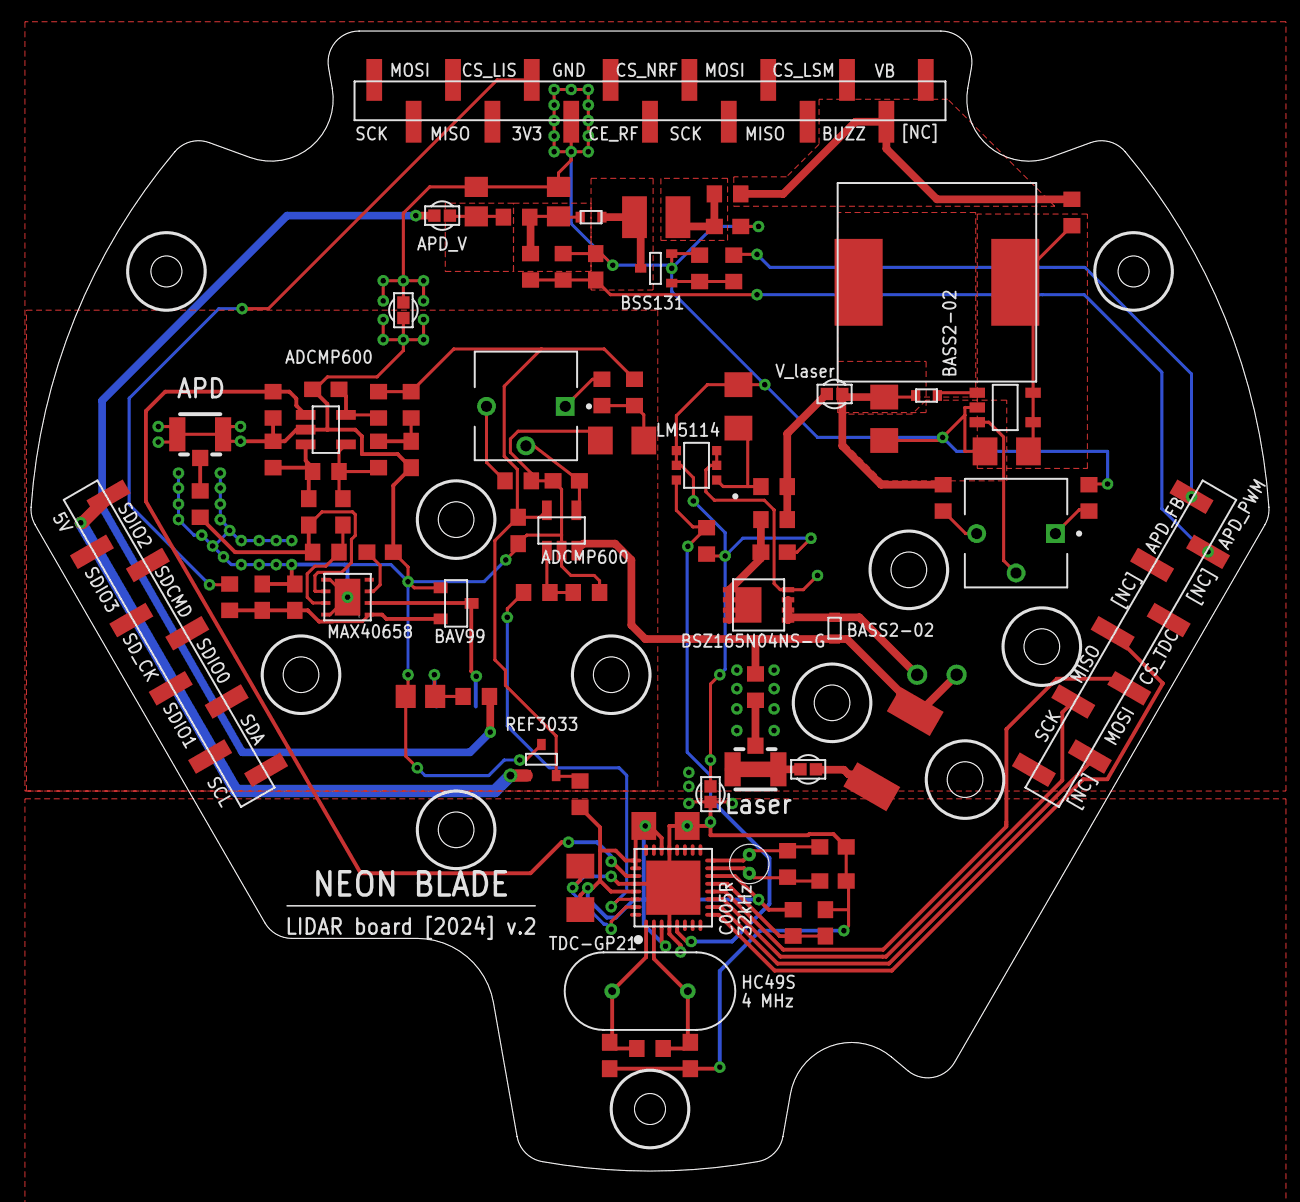
[picture p29: board lidar_made_by_apple.brd from above]

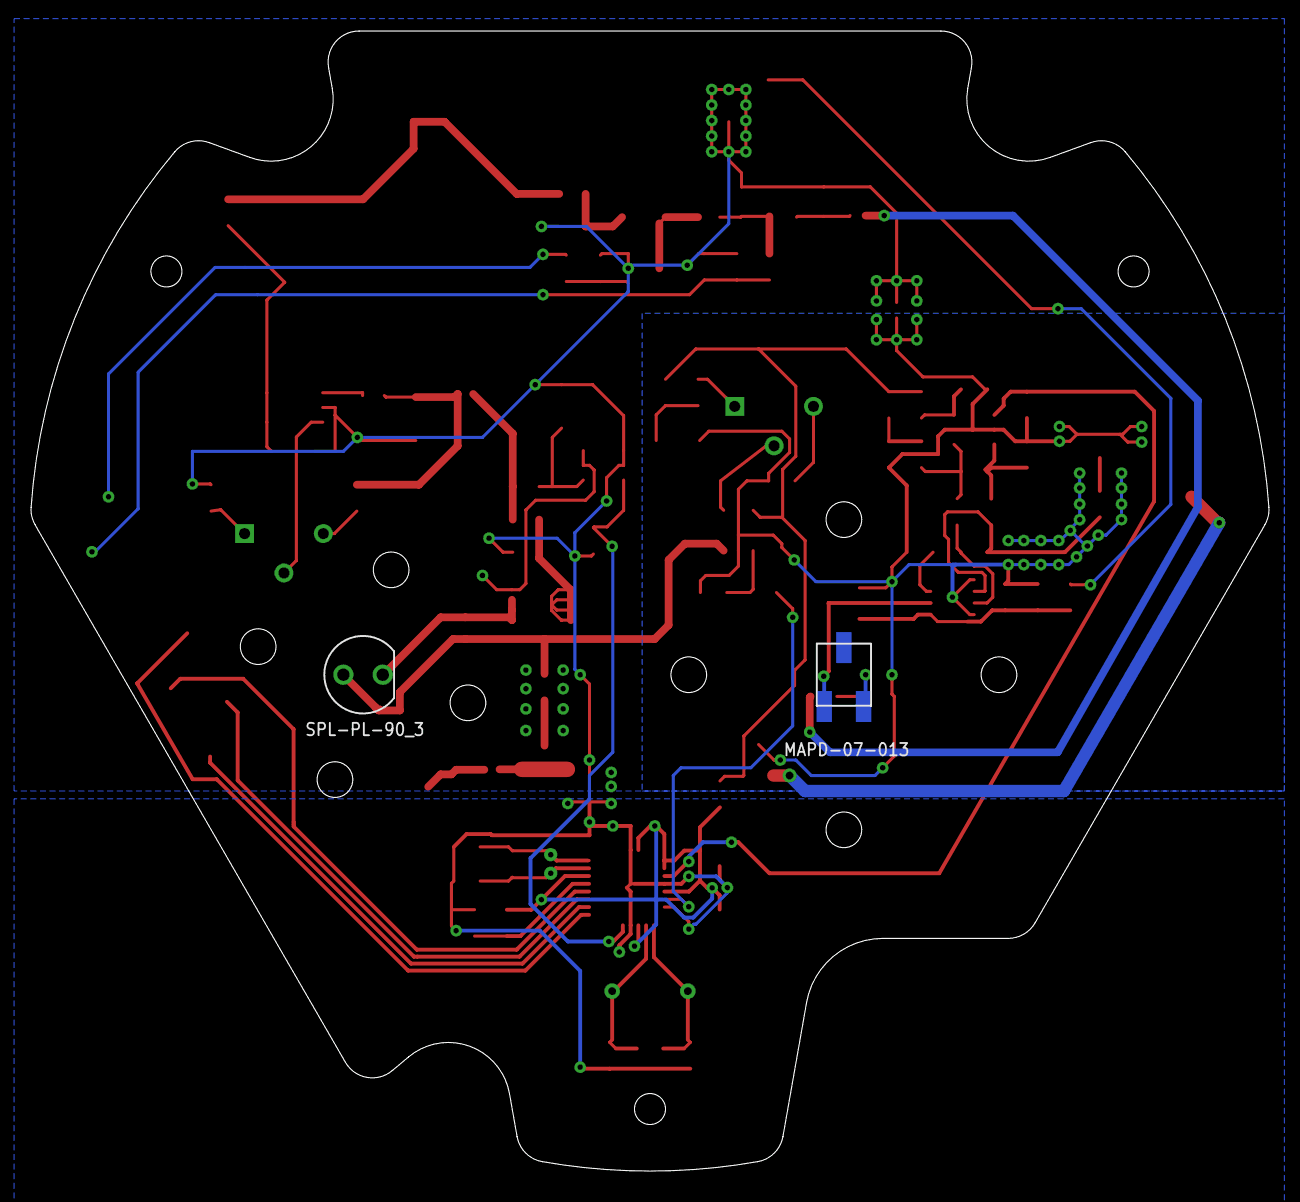
[picture p30: board lidar_made_by_apple.brd from below]

Board: 2 copper layers, 79.8 x 73.5 mm, 90 parts (2 on the bottom side), 58 nets.
