cansat-tsniimash/NeonBlade-2024/schematic/board/Down_Main_Board .brd

## EAGLE design schematic/board/Down_Main_Board .brd (2024-03-04)

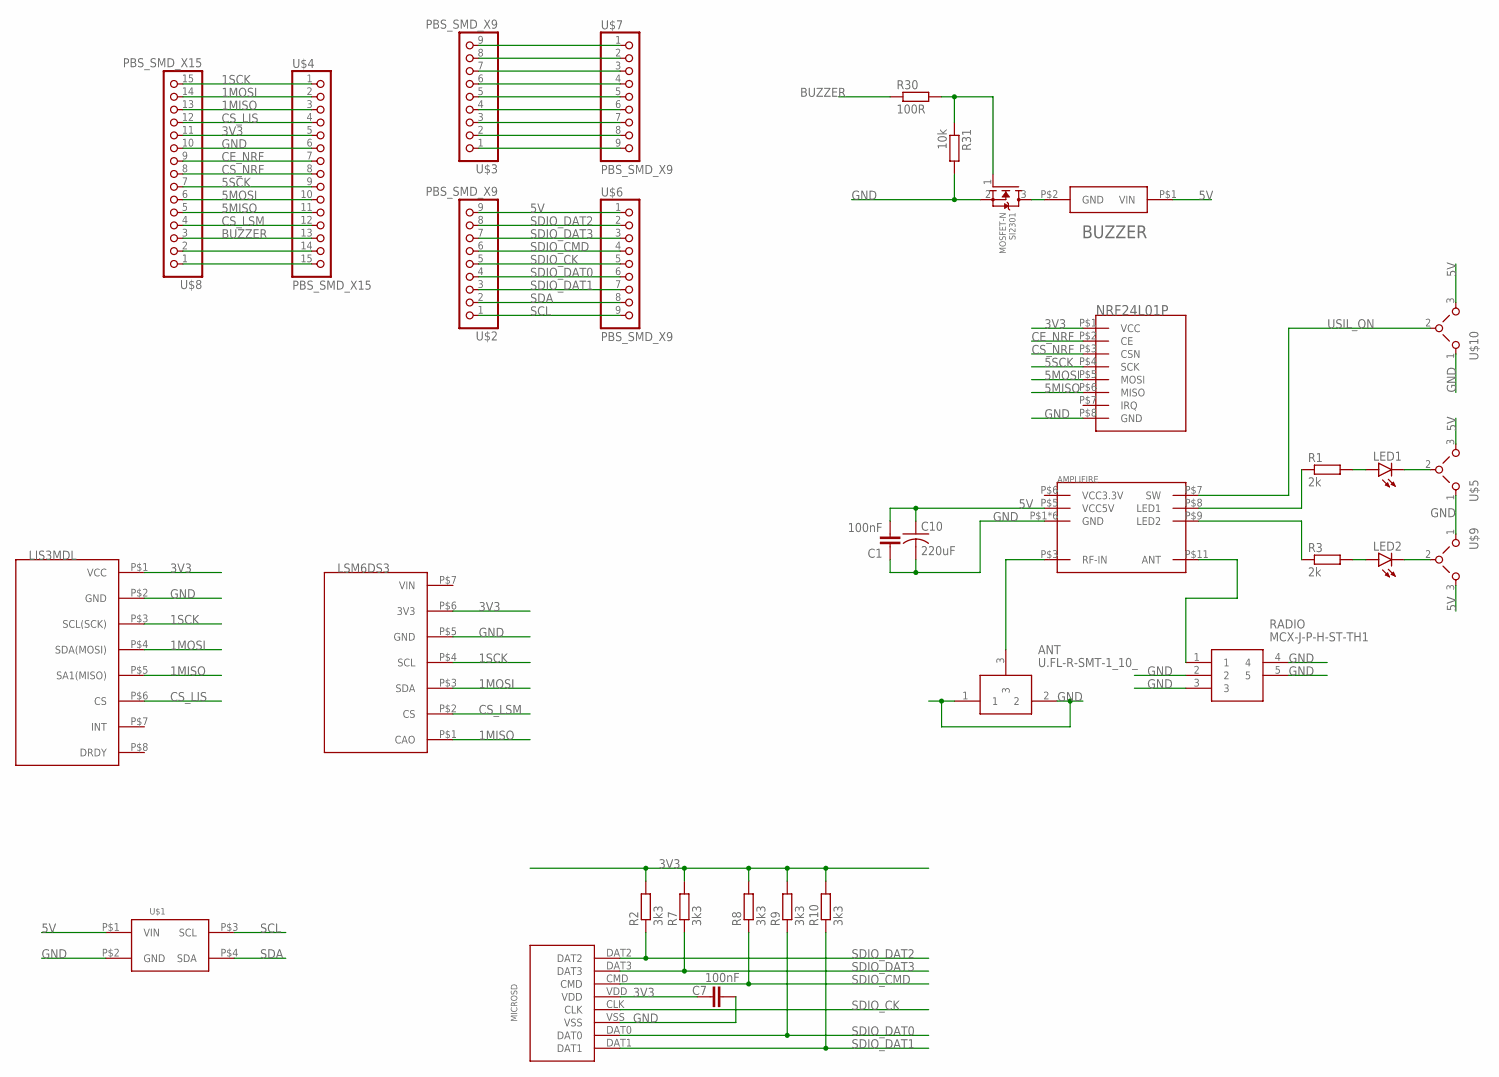
[picture p31: schematic Down_Main_Board .sch]

Parts:
AMPLIFIRE: XQ-02A
ANT: U.FL-R-SMT-1_10_; U.FL-R-SMT-1(10)
BUZZER: BUZZERS8R6; BUZZER-S8R12
C1, C7: 100nF; C0603
C10: 220uF; ECAP220-CMD
LED1, LED2: LEDCHIPLED_0603; CHIPLED_0603
LIS3MDL: LIS3MDL-CJMCUбез_отв.; LIS3MDL-CGMSU-NB2023-1
LSM6DS3: LSM6DS3-GY-NB2023
MICROSD: SD
NRF24L01P: NRF24L01_ML01SP4
R1, R3: 2k; R0603
R2, R7, R8, R9, R10: 3k3; R0603
R30: 100R; R0603
R31: 10k; R0603
RADIO: MCX-J-P-H-ST-TH1; MCXJPHSTTH1
SI2301: MOSFET-N; SOT23-3
U$1: BME280BME280-PINS-ONLY; BME280-PINS-ONLY
U$2, U$3, U$6, U$7: PBS_SMD_X9
U$4, U$8: PBS_SMD_X15; PBD_SMD_X15
U$5, U$9, U$10: VIAS-SELECT

Connections:
1MISO: LIS3MDL.P$5 (SA1(MISO)), LSM6DS3.P$1 (CAO), U$4.3, U$8.13
1MOSI: LIS3MDL.P$4 (SDA(MOSI)), LSM6DS3.P$3 (SDA), U$4.2, U$8.14
1SCK: LIS3MDL.P$3 (SCL(SCK)), LSM6DS3.P$4 (SCL), U$4.1, U$8.15
3V3: C7.2, LIS3MDL.P$1 (VCC), LSM6DS3.P$6 (3V3), MICROSD.VDD, NRF24L01P.P$1 (VCC), R2.2, R7.2, R8.2, R9.2, R10.2, U$4.5, U$8.11
5MISO: NRF24L01P.P$6 (MISO), U$4.11, U$8.5
5MOSI: NRF24L01P.P$5 (MOSI), U$4.10, U$8.6
5SCK: NRF24L01P.P$4 (SCK), U$4.9, U$8.7
5V: AMPLIFIRE.P$5 (VCC5V), BUZZER.P$1 (VIN), C1.2, C10.P$1 (1), U$1.P$1 (VIN), U$2.9, U$5.3 (RIGHT), U$6.1, U$9.3 (RIGHT), U$10.3 (RIGHT)
BUZZER: R30.1, U$4.13, U$8.3
CE_NRF: NRF24L01P.P$2 (CE), U$4.7, U$8.9
CS_LIS: LIS3MDL.P$6 (CS), U$4.4, U$8.12
CS_LSM: LSM6DS3.P$2 (CS), U$4.12, U$8.4
CS_NRF: NRF24L01P.P$3 (CSN), U$4.8, U$8.8
GND: AMPLIFIRE.P$1 (GND), AMPLIFIRE.P$2 (GND), AMPLIFIRE.P$4 (GND), AMPLIFIRE.P$10 (GND), AMPLIFIRE.P$12 (GND), AMPLIFIRE.P$13 (GND), ANT.1, ANT.2, C1.1, C7.1, C10.P$2 (2), LIS3MDL.P$2 (GND), LSM6DS3.P$5 (GND), MICROSD.VSS, NRF24L01P.P$8 (GND), R31.2, RADIO.2, RADIO.3, RADIO.4, RADIO.5, SI2301.2 (S), U$1.P$2 (GND), U$4.6, U$5.1 (LEFT), U$8.10, U$9.1 (LEFT), U$10.1 (LEFT)
unnamed: R30.2, R31.1, SI2301.1 (G)
unnamed: U$4.14, U$8.2
unnamed: U$4.15, U$8.1
unnamed: AMPLIFIRE.P$3 (RF-IN), ANT.3
unnamed: AMPLIFIRE.P$11 (ANT), RADIO.1
unnamed: U$3.8, U$7.2
unnamed: U$3.7, U$7.3
unnamed: U$3.6, U$7.4
unnamed: U$3.5, U$7.5
unnamed: U$3.4, U$7.6
unnamed: U$3.3, U$7.7
unnamed: U$3.9, U$7.1
unnamed: U$3.2, U$7.8
unnamed: U$3.1, U$7.9
unnamed: LED1.C, U$5.2 (TOP)
unnamed: LED1.A, R1.2
unnamed: AMPLIFIRE.P$8 (LED1), R1.1
unnamed: LED2.C, U$9.2 (TOP)
unnamed: BUZZER.P$2 (GND), SI2301.3 (D)
unnamed: LED2.A, R3.2
unnamed: AMPLIFIRE.P$9 (LED2), R3.1
SCL: U$1.P$3 (SCL), U$2.1, U$6.9
SDA: U$1.P$4 (SDA), U$2.2, U$6.8
SDIO_CK: MICROSD.CLK, U$2.5, U$6.5
SDIO_CMD: MICROSD.CMD, R8.1, U$2.6, U$6.4
SDIO_DAT0: MICROSD.DAT0, R9.1, U$2.4, U$6.6
SDIO_DAT1: MICROSD.DAT1, R10.1, U$2.3, U$6.7
SDIO_DAT2: MICROSD.DAT2, R2.1, U$2.8, U$6.2
SDIO_DAT3: MICROSD.DAT3, R7.1, U$2.7, U$6.3
USIL_ON: AMPLIFIRE.P$7 (SW), U$10.2 (TOP)

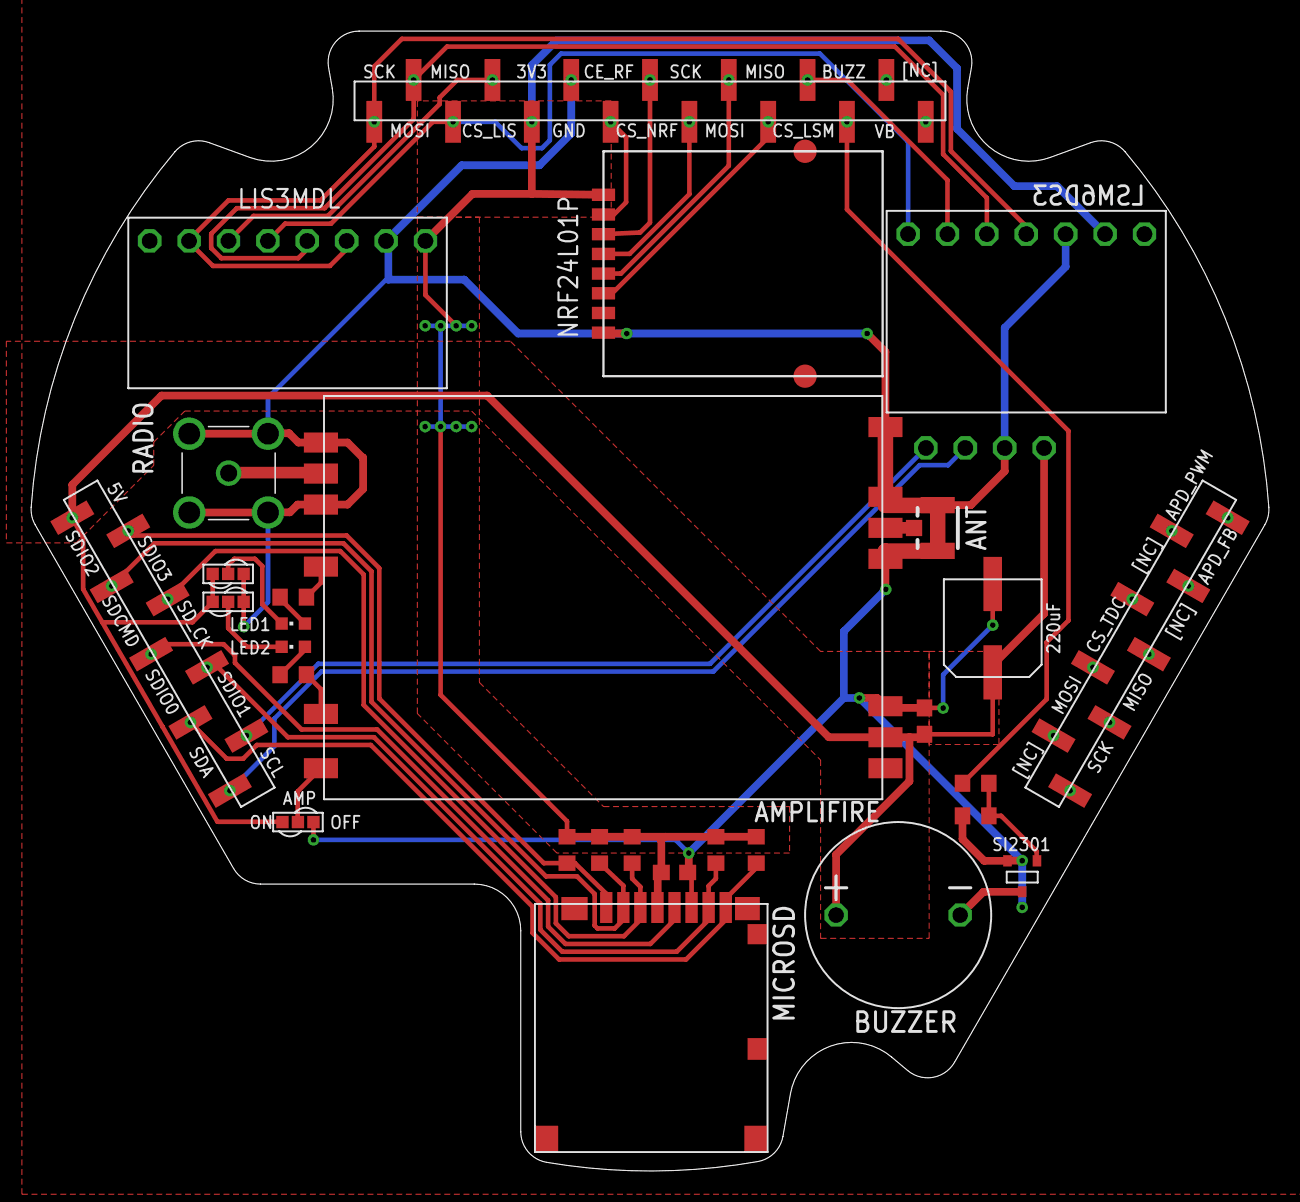
[picture p32: board Down_Main_Board .brd from above]

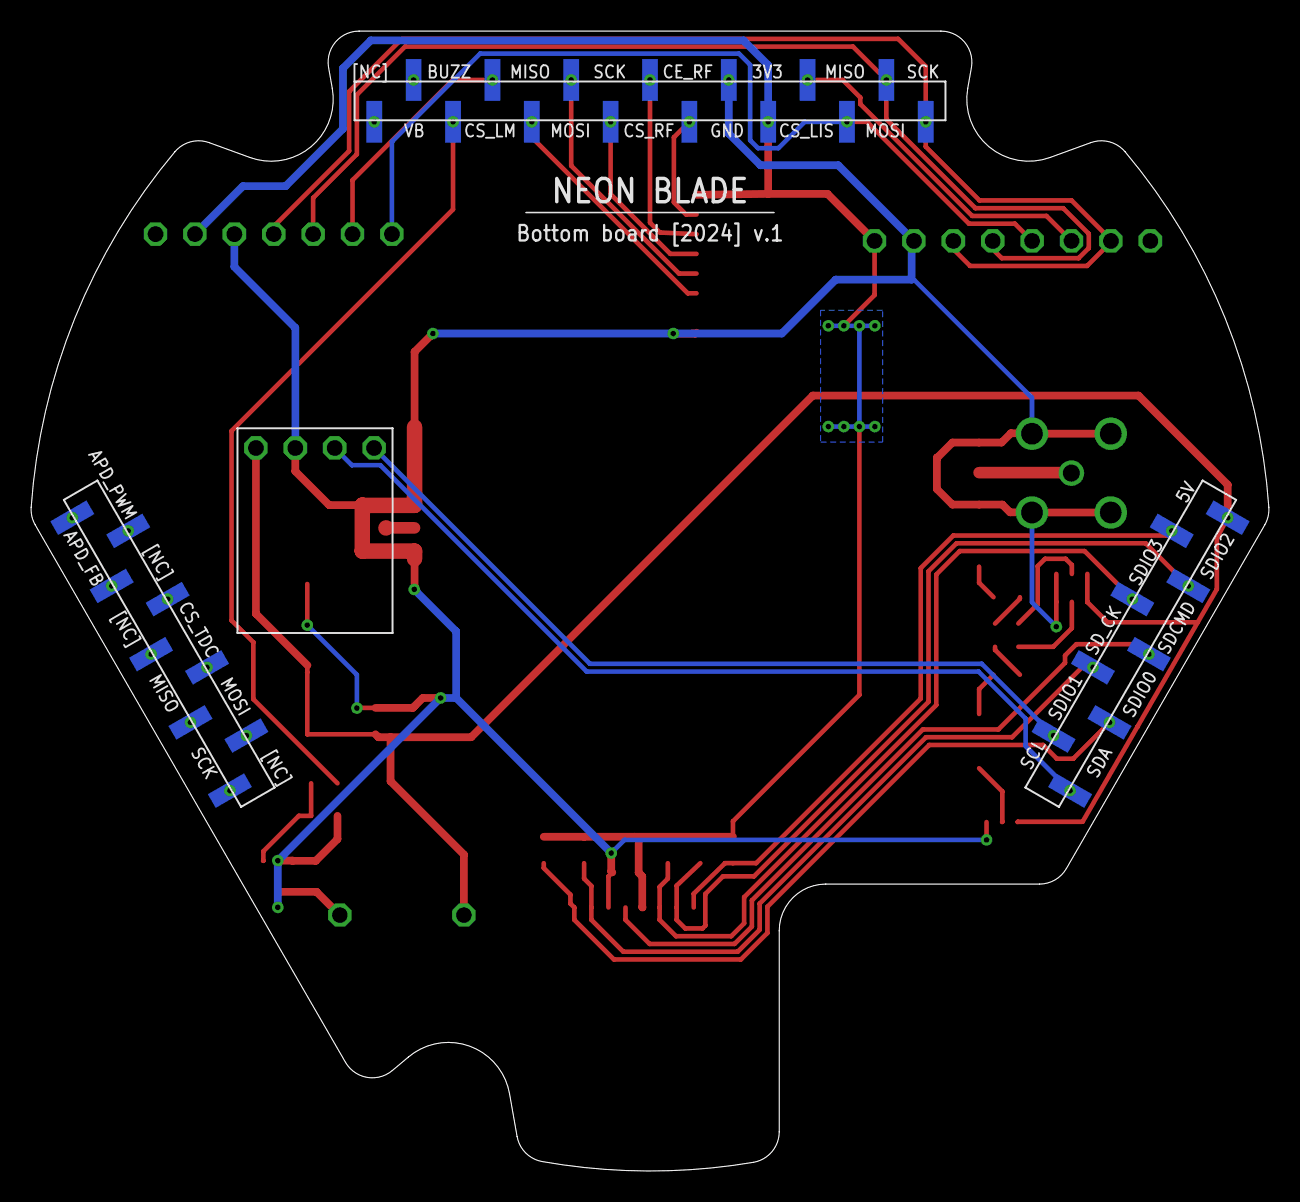
[picture p33: board Down_Main_Board .brd from below]

Board: 2 copper layers, 79.8 x 73.5 mm, 33 parts (5 on the bottom side), 44 nets.
