cansat-tsniimash/NeonBlade-2024/schematic/board/Up_Main_Board.brd

## EAGLE design schematic/board/Up_Main_Board.brd (2024-03-04)

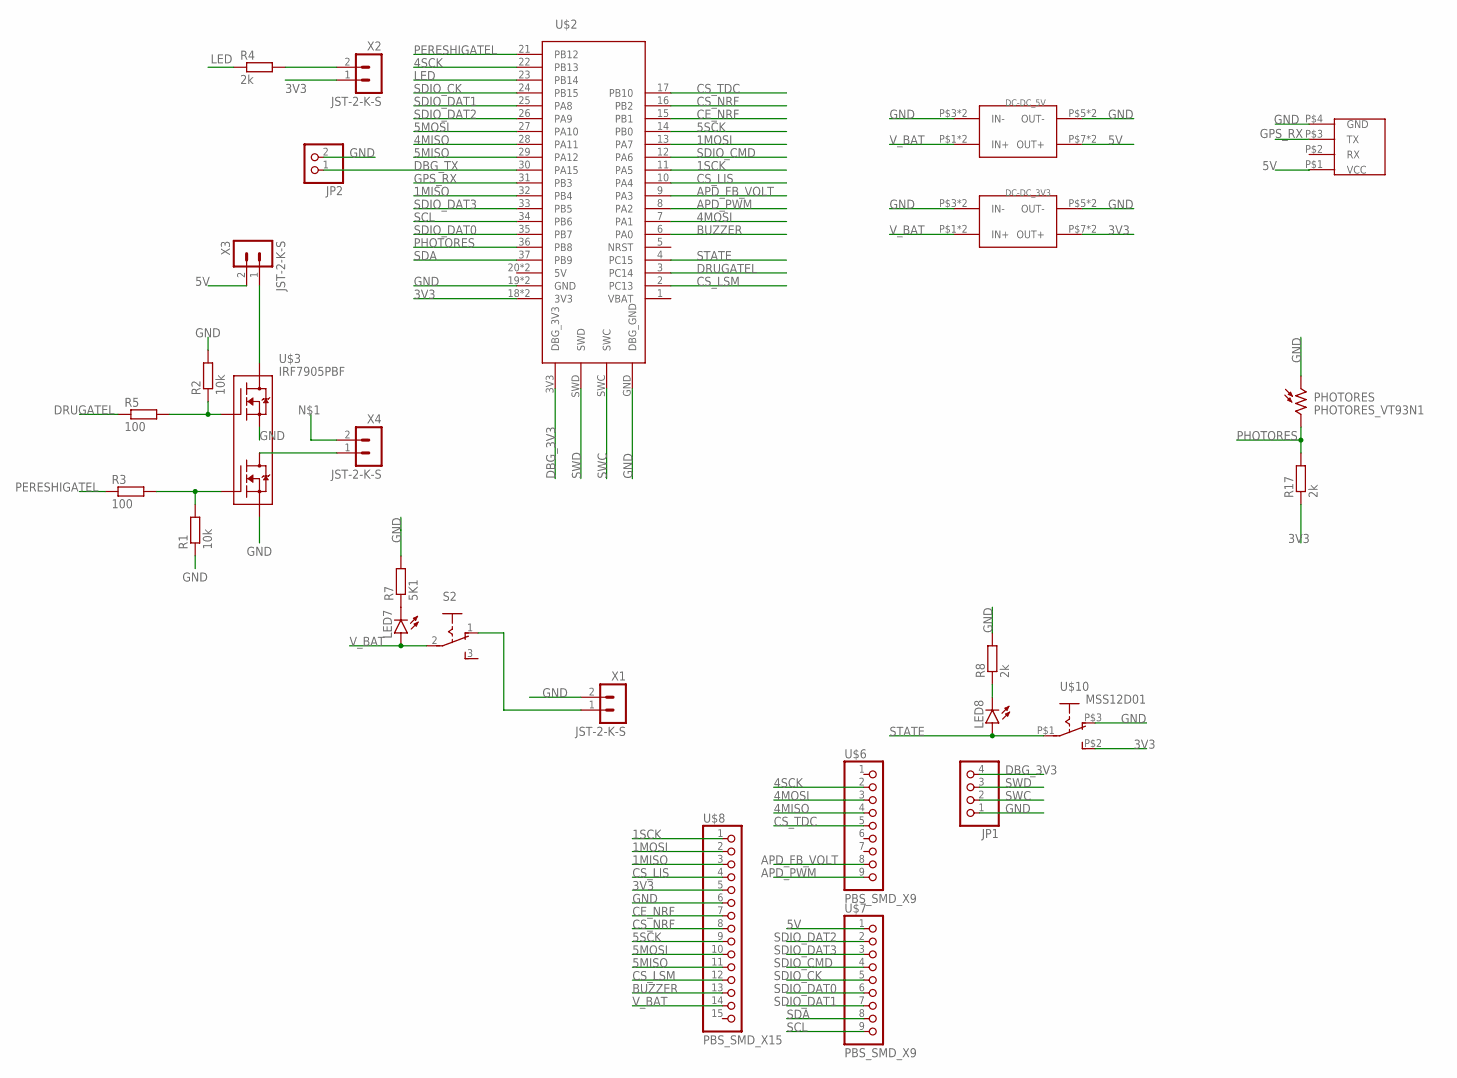
[picture p34: schematic UP_Main_Board.sch]

Parts:
DC-DC_3V3, DC-DC_5V: MP1584-B
JP1: PINHD-1X4/90; 1X04/90
JP2: PINHD-1X2; 1X02
LED7, LED8: LEDSML0603; SML0603
PHOTORES: PHOTORES_VT93N1; PHOTORES_VT93N1_SMD
R1, R2: 10k; R0603
R3, R5: 100; R0603
R4, R8, R17: 2k; R0603
R7: 5K1; R0603
S2: UNICS-SWITCH
U$1: GPS_NEO6M; GPS_NEO6M_NEW
U$2: STM32F401_BOARD
U$3: IRF7905PBF; SO8
U$6, U$7: PBS_SMD_X9
U$8: PBS_SMD_X15; PBD_SMD_X15
U$10: MSS12D01
X1, X2, X3, X4: JST-2-K-S; B2B-PH-K-S

Connections:
1MISO: U$2.32 (PB4), U$8.3
1MOSI: U$2.13 (PA7), U$8.2
1SCK: U$2.11 (PA5), U$8.1
3V3: DC-DC_3V3.P$7 (OUT+), DC-DC_3V3.P$8 (OUT+), R17.1, U$2.18 (3V3), U$2.40 (3V3), U$8.5, U$10.P$2 (S), X2.1
4MISO: U$2.28 (PA11), U$6.4
4MOSI: U$2.7 (PA1), U$6.3
4SCK: U$2.22 (PB13), U$6.2
5MISO: U$2.29 (PA12), U$8.11
5MOSI: U$2.27 (PA10), U$8.10
5SCK: U$2.14 (PB0), U$8.9
5V: DC-DC_5V.P$7 (OUT+), DC-DC_5V.P$8 (OUT+), U$1.P$1 (VCC), U$7.1, X3.2
APD_FB_VOLT: U$2.9 (PA3), U$6.8
APD_PWM: U$2.8 (PA2), U$6.9
BUZZER: U$2.6 (PA0), U$8.13
CE_NRF: U$2.15 (PB1), U$8.7
CS_LIS: U$2.10 (PA4), U$8.4
CS_LSM: U$2.2 (PC13), U$8.12
CS_NRF: U$2.16 (PB2), U$8.8
CS_TDC: U$2.17 (PB10), U$6.5
DBG_3V3: JP1.4, U$2.3V3 (DBG_3V3)
DBG_TX: JP2.1, U$2.30 (PA15)
DRUGATEL: R5.1, U$2.3 (PC14)
GND: DC-DC_3V3.P$3 (IN-), DC-DC_3V3.P$4 (IN-), DC-DC_3V3.P$5 (OUT-), DC-DC_3V3.P$6 (OUT-), DC-DC_5V.P$3 (IN-), DC-DC_5V.P$4 (IN-), DC-DC_5V.P$5 (OUT-), DC-DC_5V.P$6 (OUT-), JP1.1, JP2.2, PHOTORES.P$1 (1), R1.1, R2.2, R7.2, R8.2, U$1.P$4 (GND), U$2.19 (GND), U$2.39 (GND), U$2.GND (DBG_GND), U$3.1 (S2), U$3.3 (S1), U$8.6, U$10.P$3 (O), X1.2
GPS_RX: U$1.P$3 (TX), U$2.31 (PB3)
LED: R4.1, U$2.23 (PB14)
unnamed: S2.1 (O), X1.1, X4.2
unnamed: U$3.5 (D1), U$3.6 (D1), X3.1
unnamed: R2.1, R5.2, U$3.4 (G1)
unnamed: LED7.C, R7.1
unnamed: R1.2, R3.2, U$3.2 (G2)
unnamed: R4.2, X2.2
unnamed: U$3.7 (D2), U$3.8 (D2), X4.1
unnamed: LED8.C, R8.1
PERESHIGATEL: R3.1, U$2.21 (PB12)
PHOTORES: PHOTORES.P$2 (2), R17.2, U$2.36 (PB8)
SCL: U$2.34 (PB6), U$7.9
SDA: U$2.37 (PB9), U$7.8
SDIO_CK: U$2.24 (PB15), U$7.5
SDIO_CMD: U$2.12 (PA6), U$7.4
SDIO_DAT0: U$2.35 (PB7), U$7.6
SDIO_DAT1: U$2.25 (PA8), U$7.7
SDIO_DAT2: U$2.26 (PA9), U$7.2
SDIO_DAT3: U$2.33 (PB5), U$7.3
STATE: LED8.A, U$2.4 (PC15), U$10.P$1
SWC: JP1.2, U$2.SWC
SWD: JP1.3, U$2.SWD
V_BAT: DC-DC_3V3.P$1 (IN+), DC-DC_3V3.P$2 (IN+), DC-DC_5V.P$1 (IN+), DC-DC_5V.P$2 (IN+), LED7.A, S2.2, U$8.14

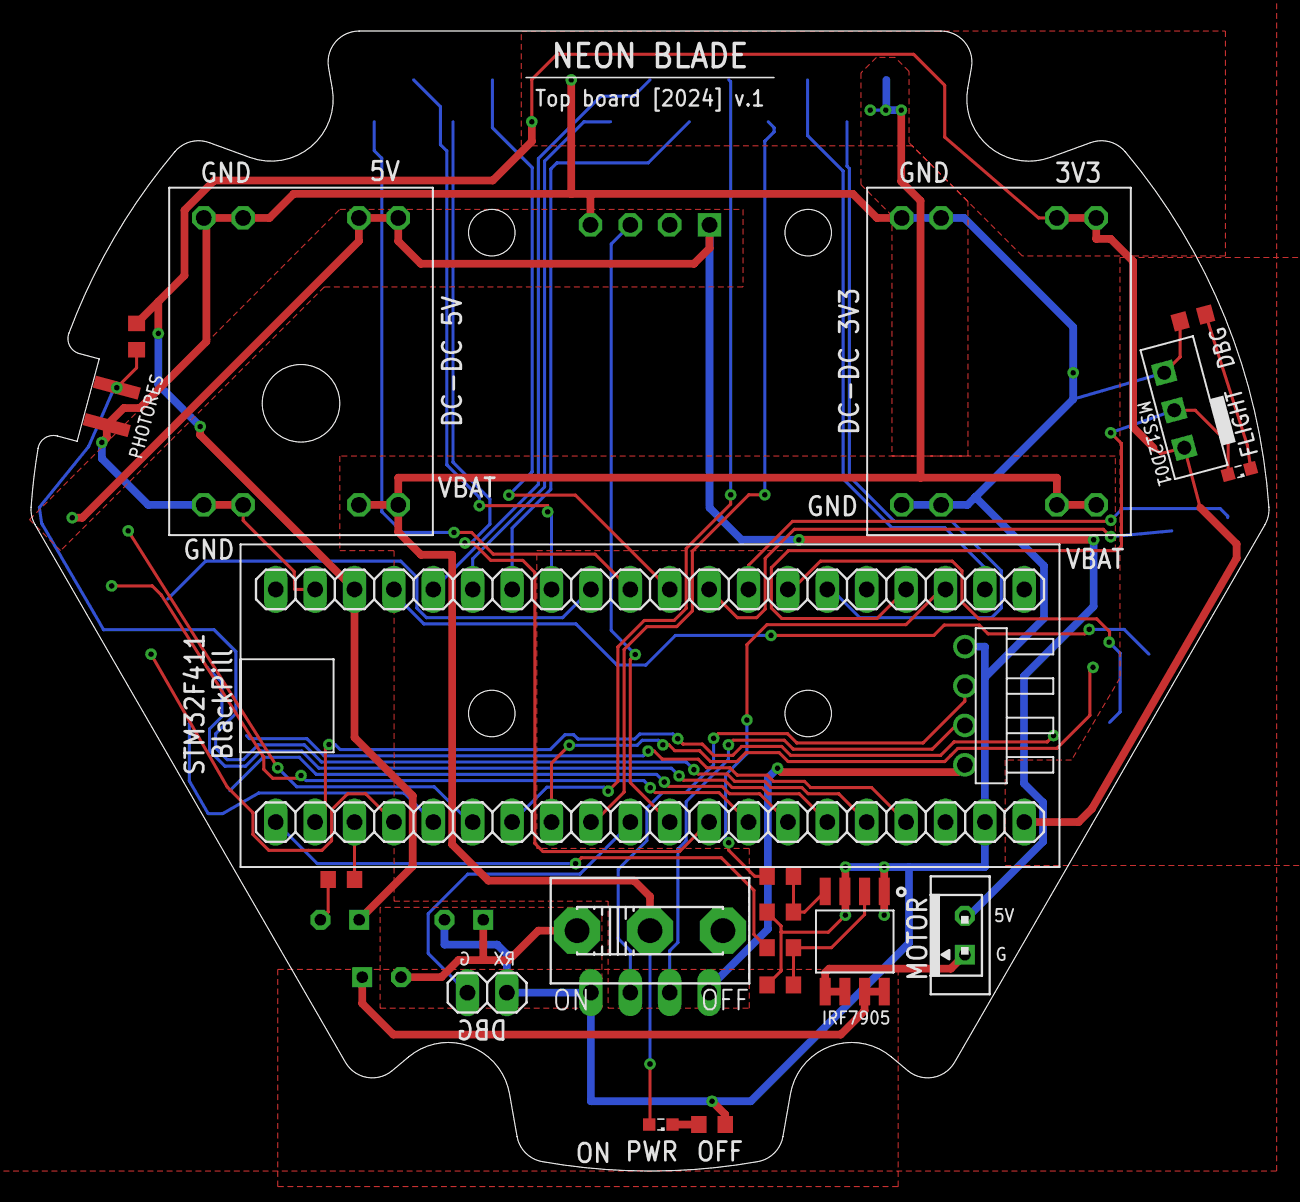
[picture p35: board Up_Main_Board.brd from above]

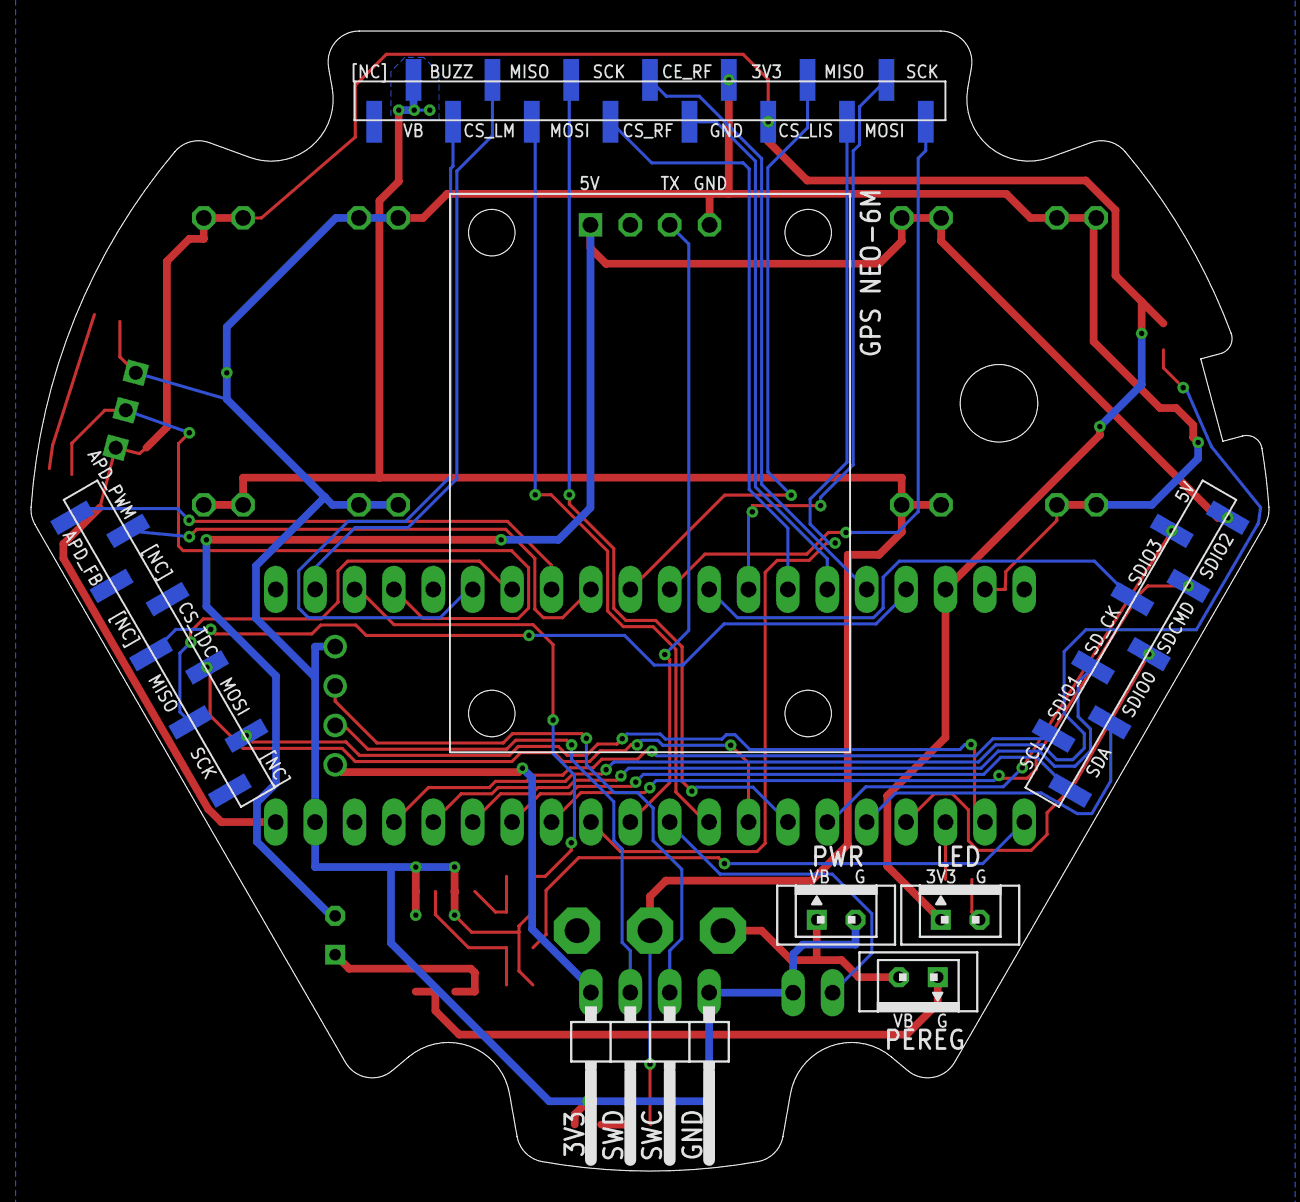
[picture p36: board Up_Main_Board.brd from below]

Board: 2 copper layers, 79.8 x 73.5 mm, 27 parts (8 on the bottom side), 47 nets.
