cansat-tsniimash/NeonBlade-2024/schematic/board/Cansat-2024-1.brd

## EAGLE design schematic/board/Cansat-2024-1.brd (2024-03-04)

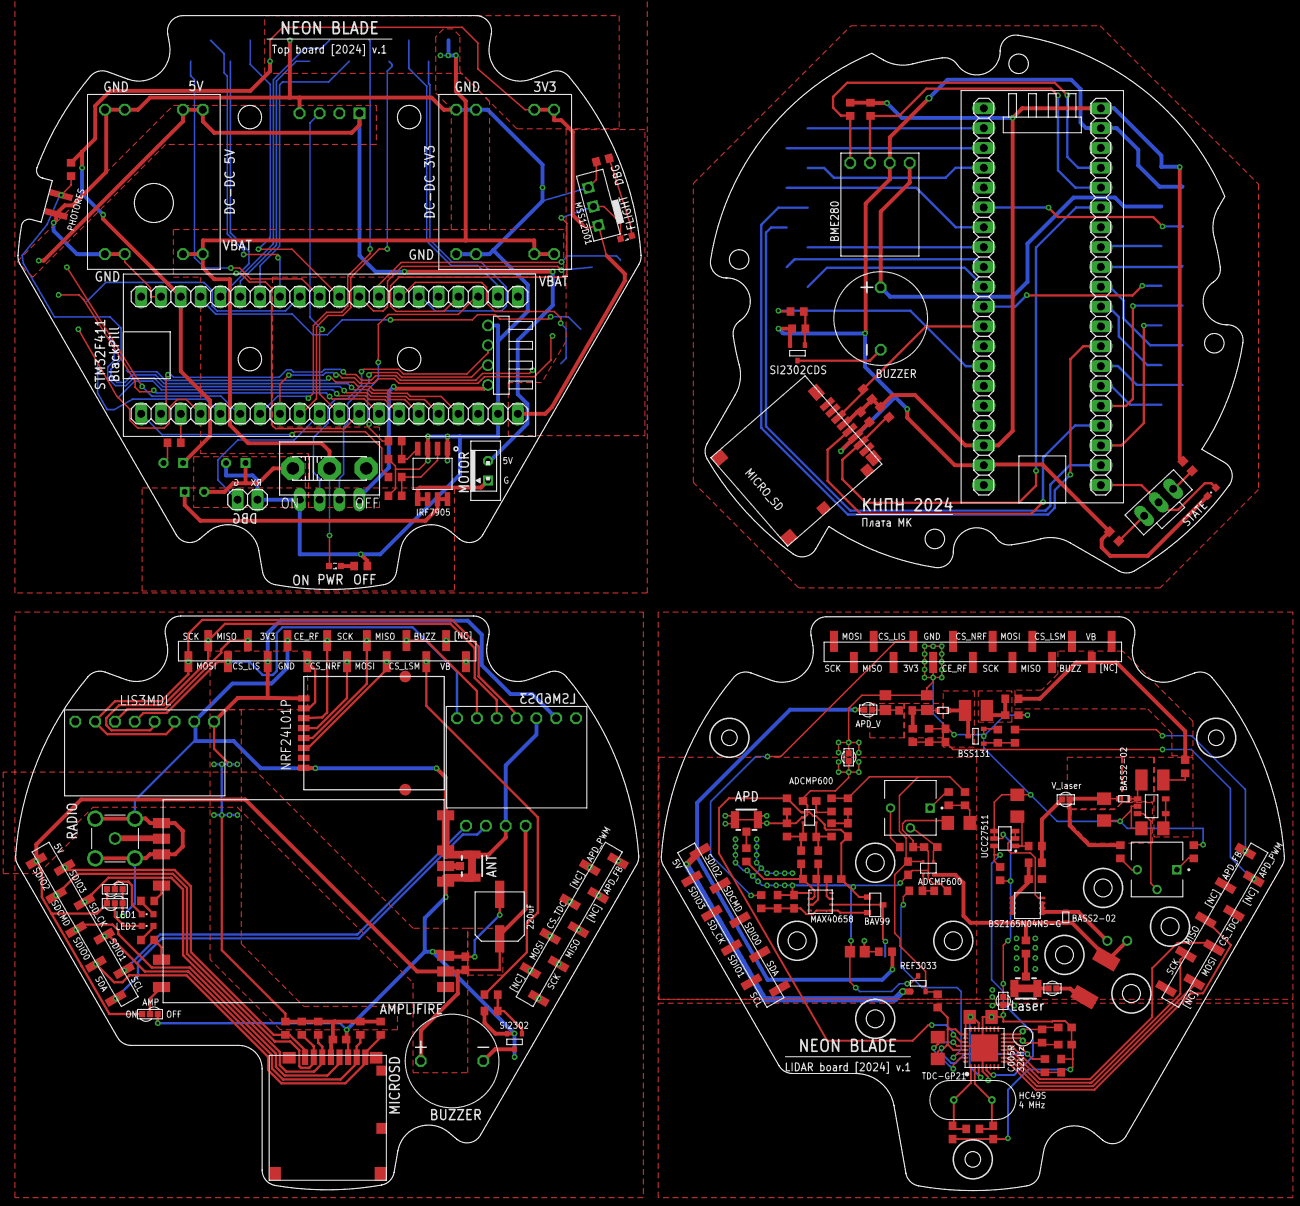
[picture p37: board Cansat-2024-1.brd from above]

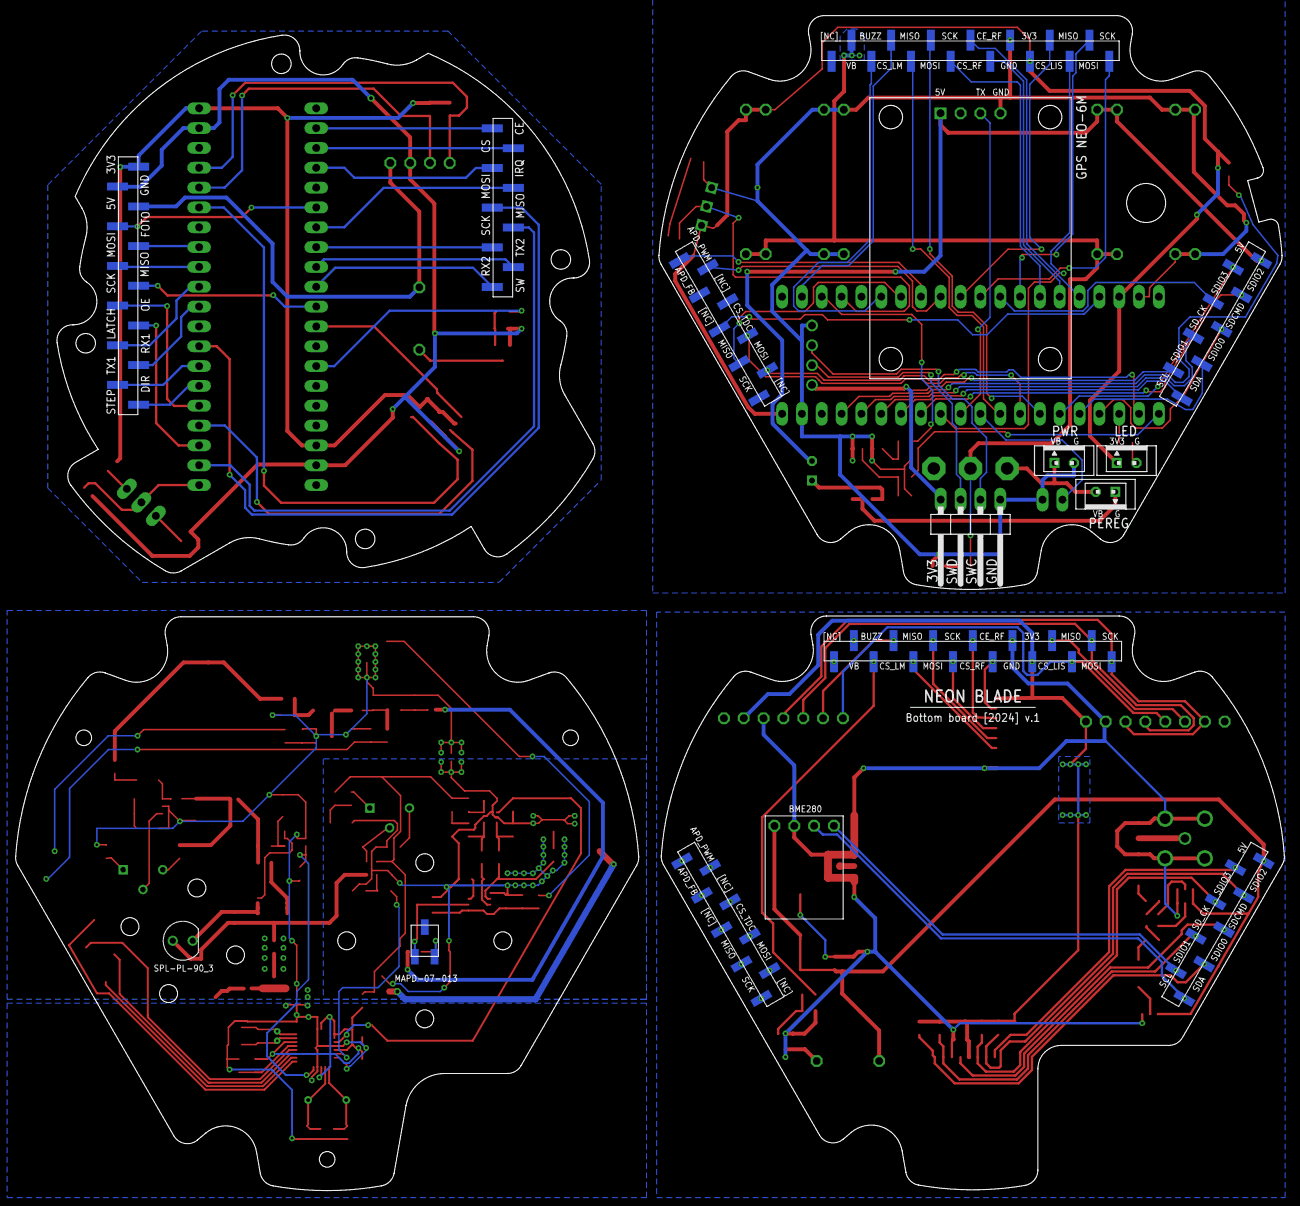
[picture p38: board Cansat-2024-1.brd from below]

Board: 2 copper layers, 162.5 x 150.5 mm, 169 parts (17 on the bottom side), 182 nets.

Parts:
AMPLIFIRE: XQ-02A
ANT: U.FL-R-SMT-1_10_; U.FL-R-SMT-1(10)
BME280: BME280BME280-PINS-ONLY; BME280-PINS-ONLY
BUZZER, BUZZER1: BUZZERS8R6; BUZZER-S8R12
C1, C7, C12, C23, C24, C27, C28, C29: 100nF; C0603
C2, C3: 15pF; C0603
C4, C9, C16, C19: 10uF; C1206
C5: 10nF 250v; C0805
C6, C13, C14, C26: 1uF; C0603
C8: 100pF; C0603
C10: 220uF; ECAP220-CMD
C11, C33: 10nF 250V; C0805
C15, C25: 10nF; C0603
C17: 22nF low ESR; C0603
C18, C20: 22uF; C1206
C21, C22: 10pF; C0603
D1: BAS521; SOD523
D2: BAS52-02; SOD523
D6: BAV99
DC-DC_3V3, DC-DC_5V: MP1584-B
J1, J2: U.FL-R-SMT-1_10_; U.FL-R-SMT-1(10)
JP1: 1X04/90
JP2: 1X02
L1, L2, L4, L6, L7, L8, L9, L10: L_BEAD
L3: 10uH; L_1210
L5: 47uH; 1210
LED1, LED2: CHIPLED_0603
LED7, LED8: SML0603
LIS3MDL: LIS3MDL-CJMCUбез_отв.; LIS3MDL-CGMSU-NB2023-1
LSM6DS3: LSM6DS3-GY-NB2023
MICROSD: SD
MICRO_SD: SD
NRF24L01P: NRF24L01_ML01SP4
PHOTORES: PHOTORES_VT93N1; PHOTORES_VT93N1_SMD
R1, R3, R4, R6, R17, R45, R46: 2k; R0603
R2, R7, R8, R9, R10: 3k3; R0603
R5: 5K1; R0603
R11, R12, R31, R43, R49, R50: 10k; R0603
R13, R14: 100; R0603
R15, R19, R25, R32, R41: 4.7k; R0603
R16: 560k; R0603
R18, R20: 47k; R0603
R21, R30, R44: 100R; R0603
R22: 2M; R0603
R23: 20k; R0603
R24: 10M; R0603
R26, R35, R38, R39: 1k; R0603
R27: 270; R0603
R28: R100; R2512
R29, R37: 47R; R0603
R33: 100k; R0603
R34: 0R; R0603
R36: NC; R0603
R40: 150R; R0603
R42: 4k7; R0603
R47, R48: 5k1; R0603
RADIO: MCX-J-P-H-ST-TH1; MCXJPHSTTH1
REF3033: REF3033; SOT23-3
S2: UNICS-SWITCH
SI2302: MOSFET-N; SOT23-3
SI2302CDS: SI2302CDS; SOT23-3
STATE: CHIPLED_0603
STM: STM32F411_BOARD
U$1: BME280BME280-PINS-ONLY; BME280-PINS-ONLY
U$2, U$3, U$6, U$7, U$13, U$14, U$23, U$24, U$38: PBS_SMD_X9
U$4, U$8, U$15, U$25: PBS_SMD_X15; PBD_SMD_X15
U$5, U$9, U$10: VIAS-SELECT
U$11: STM32F401_BOARD
U$12: MSS12D01
U$16: GPS_NEO6M; GPS_NEO6M_NEW
U$17: IRF7905PBF; SO8
U$18: TDC-GP21
U$19: C005R
U$20: HC49S
U$21: MIC2288
U$22: BSS131; SOT23-3
U$26: UCC27511DBVR
U$27: BSZ165N04NS-G
U$28: BAS52-02; SOD523
U$29: SPL_PL-90
U$30, U$32: ADCMP600
U$31: MAX40658-8-TDFN-3X3MM
U$33: MTAPD-07-013; MAPD-07-013
U$34, U$35: VIAS-CONNECT
U$36: SWITCH_MSS
U$37: PBS_SMD_X13; PBD_SMD_X13
U$39: Плата МК; LOGO
VR1, VR2: 3362P-1-502LF; TRIM_3362P-1-502LF
W1, W3, W5: VIAS-CONNECT
X1, X2, X3, X4: JST-2-K-S; B2B-PH-K-S

Connections:
1MISO: LIS3MDL.P$5, LSM6DS3.P$1, U$4.3, U$8.13
1MISO1: U$11.32, U$15.3
1MOSI: LIS3MDL.P$4, LSM6DS3.P$3, U$4.2, U$8.14
1MOSI1: U$11.13, U$15.2
1SCK: LIS3MDL.P$3, LSM6DS3.P$4, U$4.1, U$8.15
1SCK1: U$11.11, U$15.1
3V1: DC-DC_3V3.P$7, DC-DC_3V3.P$8, R17.1, U$11.18, U$11.40, U$12.P$2, U$15.5, X2.1
3V2: L1.1, U$25.5
3V3: C7.2, LIS3MDL.P$1, LSM6DS3.P$6, MICROSD.VDD, NRF24L01P.P$1, R2.2, R7.2, R8.2, R9.2, R10.2, U$4.5, U$8.11
3V3_REF: C24.1, L6.1, L7.1, L9.2, L10.1, REF3033.2, U$30.P$5
3V4: C28.2, MICRO_SD.VDD, R46.2, R47.2, R48.2, R49.1, R50.1, STM.18, STM.40, U$37.1
4MISO: U$11.28, U$13.4
4MISO1: U$18.12, U$23.4
4MOSI: U$11.7, U$13.3
4MOSI1: U$18.11, U$23.3
4SCK: U$11.22, U$13.2
4SCK1: U$18.10, U$23.2
5MISO: NRF24L01P.P$6, U$4.11, U$8.5
5MISO1: U$11.29, U$15.11
5MOSI: NRF24L01P.P$5, U$4.10, U$8.6
5MOSI1: U$11.27, U$15.10
5SCK: NRF24L01P.P$4, U$4.9, U$8.7
5SCK1: U$11.14, U$15.9
5V: AMPLIFIRE.P$5, BUZZER.P$1, C1.2, C10.P$1, U$1.P$1, U$2.9, U$5.3, U$6.1, U$9.3, U$10.3
5V1: DC-DC_5V.P$7, DC-DC_5V.P$8, U$14.1, U$16.P$1, X3.2
5V2: REF3033.1, U$24.1
5V3: BME280.P$4, BUZZER1.P$2, U$37.3
ADC_FOTO: STM.6, U$37.4
AGND: C12.2, C13.2, C14.2, C19.1, C23.2, C24.2, C26.1, C27.1, C33.2, D6.P$1, J1.1, J1.2, R32.1, R35.1, R39.1, R42.2, REF3033.3, U$30.P$2, U$31.P$5, U$32.P$2, W5.1
APD_COMP_OUT: R39.2, U$18.27, U$32.P$1
APD_FB_VOLT: U$11.9, U$13.8
APD_FB_VOLT1: C8.2, R22.1, R23.2, U$23.8
APD_PWM: U$11.8, U$13.9
APD_PWM1: R21.2, U$23.9
APD_V: C11.2, R25.1, U$34.1
APD_V_: R38.2, U$34.2
BUZZER: R30.1, U$4.13, U$8.3
BUZZER1: U$11.6, U$15.13
BUZZER2: R44.1, STM.14
CE_NRF: NRF24L01P.P$2, U$4.7, U$8.9
CE_NRF1: U$11.15, U$15.7
CE_RADIO: STM.2, U$38.9
CMD_SD: MICRO_SD.CMD, R50.2, STM.12
COMP_N: C15.2, R40.1, R41.2, U$32.P$4
COMP_P: C25.2, R40.2, R42.1, U$32.P$3
CS_LIS: LIS3MDL.P$6, U$4.4, U$8.12
CS_LIS1: U$11.10, U$15.4
CS_LSM: LSM6DS3.P$2, U$4.12, U$8.4
CS_LSM1: U$11.2, U$15.12
CS_NRF: NRF24L01P.P$3, U$4.8, U$8.8
CS_NRF1: U$11.16, U$15.8
CS_RADIO: STM.3, U$38.8
CS_TDC: U$11.17, U$13.5
CS_TDC1: U$18.9, U$23.5
D0_SD: MICRO_SD.DAT0, R49.2, STM.35
DBG_3V3: JP1.4, U$11.3V3
DBG_TX: JP2.1, U$11.30
DIR_DRIVER: STM.27, U$37.12
DRUGATEL: R14.1, U$11.3
GND: AMPLIFIRE.P$1, AMPLIFIRE.P$2, AMPLIFIRE.P$4, AMPLIFIRE.P$10, AMPLIFIRE.P$12, AMPLIFIRE.P$13, ANT.1, ANT.2, C1.1, C7.1, C10.P$2, LIS3MDL.P$2, LSM6DS3.P$5, MICROSD.VSS, NRF24L01P.P$8, R31.2, RADIO.2, RADIO.3, RADIO.4, RADIO.5, SI2302.2, U$1.P$2, U$4.6, U$5.1, U$8.10, U$9.1, U$10.1
GND1: DC-DC_3V3.P$3, DC-DC_3V3.P$4, DC-DC_3V3.P$5, DC-DC_3V3.P$6, DC-DC_5V.P$3, DC-DC_5V.P$4, DC-DC_5V.P$5, DC-DC_5V.P$6, JP1.1, JP2.2, PHOTORES.P$1, R4.2, R5.2, R11.1, R12.2, U$11.19, U$11.39, U$11.GND, U$12.P$3, U$15.6, U$16.P$4, U$17.1, U$17.3, X1.2
GND2: C2.1, C3.1, C18.1, C20.1, C21.1, C22.1, C29.2, U$18.4, U$18.21, U$18.28, U$18.31, U$18.P$1, W1.2
GND3: BME280.P$3, C28.1, MICRO_SD.VSS, R43.2, R45.2, SI2302CDS.2, STATE.C, STM.19, STM.39, U$37.2
GPS_RX: U$11.31, U$16.P$3
IRQ_RADIO: STM.4, U$38.7
I_LASER: R28.2, R29.2, U$28.P$2, U$29.P$2, U$30.P$3
LASER_COMP: R34.1, U$18.30
LASER_PULSE: R26.2, U$18.5, U$26.P$6
LATCH_SR: STM.23, U$37.9
LED: R6.1, U$11.23
MISO_RADIO: STM.28, U$38.5
MISO_SR: STM.32, U$37.6
MOSI_RADIO: STM.7, U$38.6
MOSI_SR: STM.33, U$37.5
unnamed: R30.2, R31.1, SI2302.1
unnamed: U$4.14, U$8.2
unnamed: U$4.15, U$8.1
unnamed: AMPLIFIRE.P$3, ANT.3
unnamed: AMPLIFIRE.P$11, RADIO.1
unnamed: U$3.8, U$7.2
unnamed: U$3.7, U$7.3
unnamed: U$3.6, U$7.4
unnamed: U$3.5, U$7.5
unnamed: U$3.4, U$7.6
unnamed: U$3.3, U$7.7
unnamed: U$3.9, U$7.1
unnamed: LED8.C, R4.1
unnamed: U$3.2, U$7.8
unnamed: U$3.1, U$7.9
unnamed: LED1.C, U$5.2
unnamed: LED1.A, R1.2
unnamed: AMPLIFIRE.P$8, R1.1
unnamed: LED2.C, U$9.2
unnamed: BUZZER.P$2, SI2302.3
unnamed: LED2.A, R3.2
unnamed: AMPLIFIRE.P$9, R3.1
unnamed: S2.1, X1.1, X4.2
unnamed: LED7.C, R5.1
unnamed: U$17.5, U$17.6, X3.1
unnamed: U$17.7, U$17.8, X4.1
unnamed: R12.1, R14.2, U$17.4
unnamed: R11.2, R13.2, U$17.2
unnamed: R6.2, X2.2
unnamed: C29.1, R15.1, U$18.13
unnamed: C21.2, R24.2, U$18.15, U$19.P$2
unnamed: C22.2, R24.1, U$18.16, U$19.P$1
unnamed: C2.2, R16.1, U$18.2, U$20.P$1
unnamed: C3.2, R16.2, U$18.1, U$20.P$2
unnamed: C4.2, L2.1, L3.1, U$21.EN, U$21.VIN
unnamed: D2.P$2, L3.2, U$21.SW
unnamed: U$21.FB, VR1.2
unnamed: R19.1, VR1.1
unnamed: R18.2, VR1.3
unnamed: R20.2, R21.1, U$22.1
unnamed: D1.P$2, L5.2, U$22.3
unnamed: C5.2, D1.P$1, R22.2, R25.2
unnamed: C6.1, L4.2, L5.1
unnamed: U$26.P$2, U$26.P$3, U$27.P$4
unnamed: C16.1, L8.2, U$26.P$1
unnamed: C17.2, R27.1, U$27.P$5, U$27.P$6, U$27.P$7, U$27.P$8
unnamed: U$27.P$1, U$27.P$2, U$27.P$3, U$28.P$1, U$29.P$1
unnamed: J2.3, R29.1
unnamed: J2.1, J2.2, W3.2
unnamed: C23.1, U$30.P$4, VR2.2
unnamed: C19.2, L10.2, R33.2
unnamed: R34.2, R35.2, U$30.P$1
unnamed: R33.1, VR2.1
unnamed: R32.2, VR2.3
unnamed: D6.P$3, U$31.P$2, U$33.P$2
unnamed: C14.1, U$31.P$3
unnamed: C15.1, R36.2, U$31.P$7
unnamed: C25.1, R36.1, R37.2, U$31.P$6
unnamed: J1.3, R37.1
unnamed: C33.1, R38.1, U$33.P$3
unnamed: C26.2, L6.2, R41.1
unnamed: C27.2, L7.2, U$32.P$5
unnamed: BUZZER1.P$1, SI2302CDS.3
unnamed: R43.1, R44.2, SI2302CDS.1
unnamed: R45.1, U$36.3
unnamed: R46.1, U$36.1
OE_SR: STM.25, U$37.8
PERESHIGATEL: R13.1, U$11.21
PGND: C4.1, C5.1, C6.2, C8.1, C9.1, C11.1, C16.2, C17.1, R19.2, R20.1, R23.1, R26.1, R28.1, U$21.GND, U$22.2, U$25.6, U$26.P$4, U$26.P$5, W1.1, W3.1, W5.2
PHOTORES: PHOTORES.P$2, R17.2, U$11.36
RX1_BLE: STM.31, U$37.10
RX2_GPS: STM.9, U$38.2
SCK_RADIO: STM.22, U$38.4
SCK_SR: STM.11, U$37.7
SCL: U$1.P$3, U$2.1, U$6.9
SCL1: U$11.34, U$14.9
SCL2: BME280.P$2, R48.1, STM.36
SDA: U$1.P$4, U$2.2, U$6.8
SDA1: U$11.37, U$14.8
SDA2: BME280.P$1, R47.1, STM.37
SDIO_CK: MICROSD.CLK, U$2.5, U$6.5
SDIO_CK1: U$11.24, U$14.5
SDIO_CMD: MICROSD.CMD, R8.1, U$2.6, U$6.4
SDIO_CMD1: U$11.12, U$14.4
SDIO_DAT0: MICROSD.DAT0, R9.1, U$2.4, U$6.6
SDIO_DAT1: MICROSD.DAT1, R10.1, U$2.3, U$6.7
SDIO_DAT2: MICROSD.DAT2, R2.1, U$2.8, U$6.2
SDIO_DAT3: MICROSD.DAT3, R7.1, U$2.7, U$6.3
SDIO_DAT4: U$11.26, U$14.2
SDIO_DAT5: U$11.33, U$14.3
SDIO_DAT6: U$11.35, U$14.6
SDIO_DAT7: U$11.25, U$14.7
SD_CK: MICRO_SD.CLK, STM.24
STATE: LED8.A, U$11.4, U$12.P$1
STEP_DRIVER: STM.26, U$37.13
SWC: JP1.2, U$11.SWC
SWD: JP1.3, U$11.SWD
SWITCH: STATE.A, STM.21, U$36.2
SW_AMP: STM.10, U$38.1
TX1_BLE: STM.30, U$37.11
TX2_GPS: STM.8, U$38.3
USIL_ON: AMPLIFIRE.P$7, U$10.2
VCC_TIA: C12.1, C13.1, D6.P$2, L1.2, U$31.P$1
VLASER: C9.2, D2.P$1, R18.1, U$35.1
VLASER_: L8.1, R27.2, U$35.2
V_BAT: DC-DC_3V3.P$1, DC-DC_3V3.P$2, DC-DC_5V.P$1, DC-DC_5V.P$2, LED7.A, S2.2, U$15.14
V_BAT1: L2.2, L4.1, U$25.14
V_TDC: C18.2, C20.2, L9.1, R15.2, U$18.3, U$18.14, U$18.22, U$18.25, U$18.26, U$18.29
