cansat-tsniimash/NeonBlade-2024/schematic/board/Cansat-2024-2.brd

## EAGLE design schematic/board/Cansat-2024-2.brd (2024-03-04)

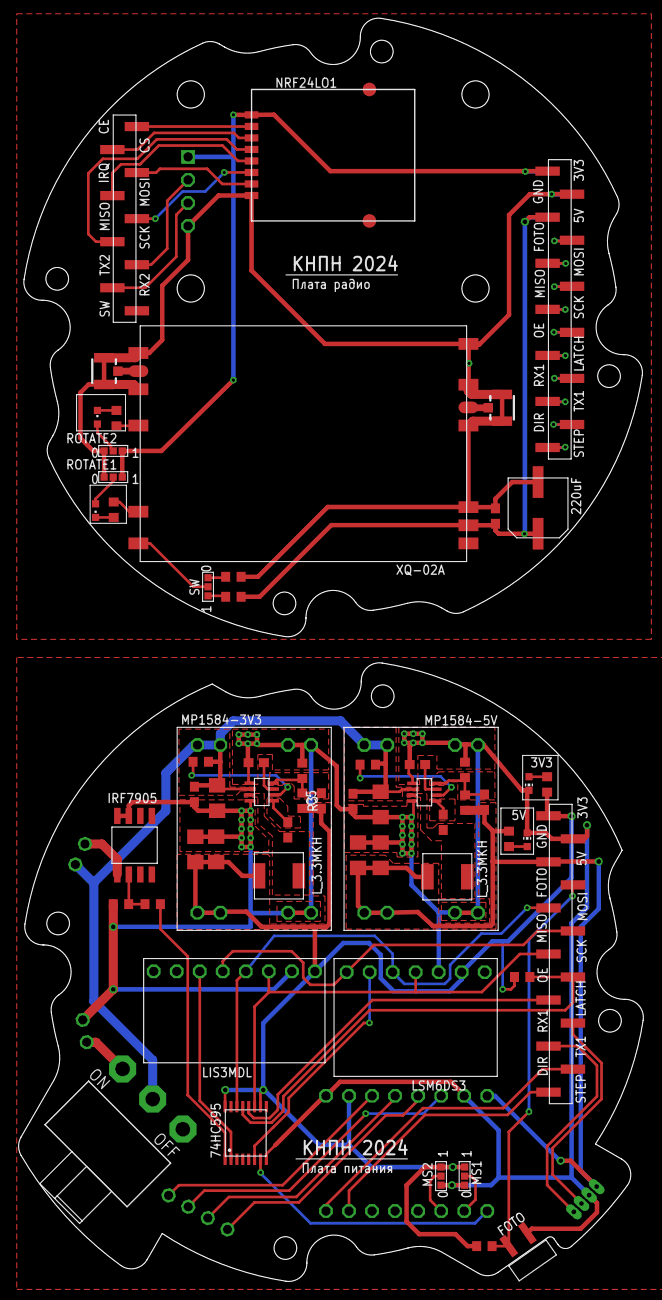
[picture p39: board Cansat-2024-2.brd from above]

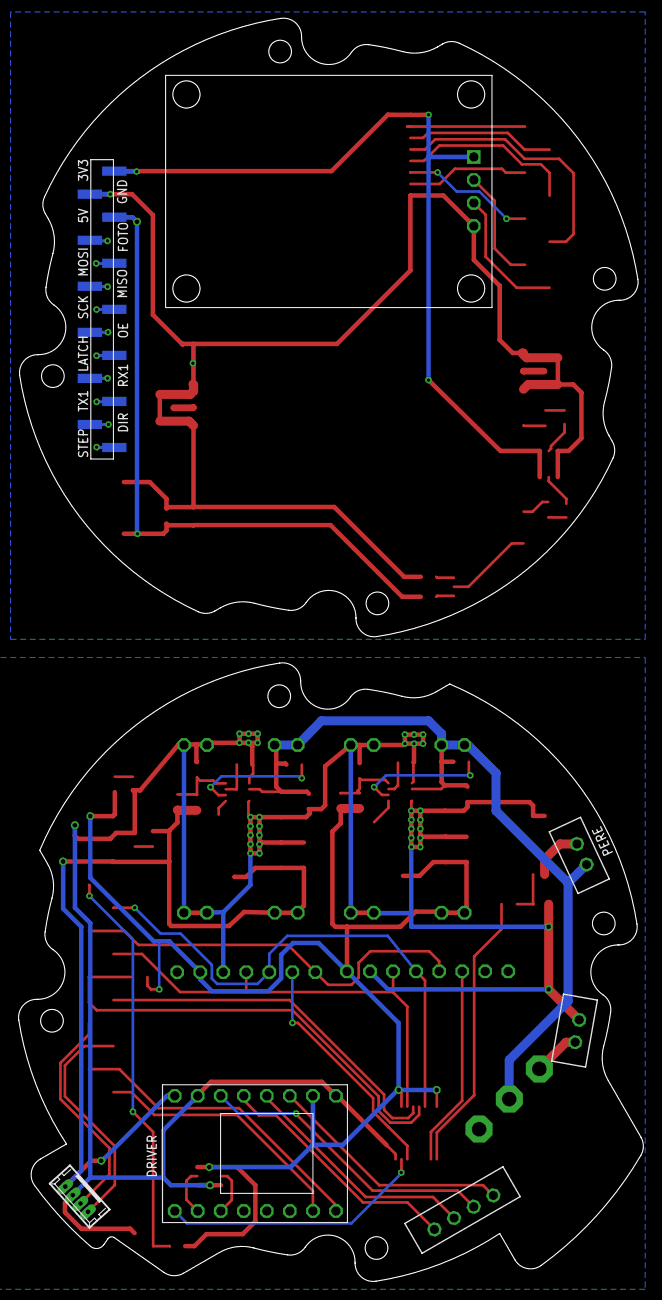
[picture p40: board Cansat-2024-2.brd from below]

Board: 2 copper layers, 68.9 x 139.3 mm, 69 parts (7 on the bottom side), 71 nets.

Parts:
3V3, 5V: CHIP-LED0603
74HC595: 74HC595; TSSOP16
C1, C4, C8, C11: 0,1u; C0603
C2, C9: 0,1u; C1206
C3, C10: 22u; C0603
C5, C12: 33p; C0603
C6, C7, C13, C14: 22u; C1206
C15: 100nF; C0603
C16: 220uF; ECAP220-CMD
DRIVER: TMC2209_WITHOUT
FOTO: VT93N1
GPS-NEO7M: GPS-NEO7M
IRF7905: IRF7905PBF; SO8
J1: IPX-RADIO; U.FL-R-SMT-1(10)
J2: IPX-ANT; U.FL-R-SMT-1(10)
LED1: AMP1; CHIPLED_0603
LED2: AMP2; CHIPLED_0603
LIS3MDL: LIS3MDL
LSM6DS3: LSM6DS3_WITHOUT
L_3.3: L_3.3MKH; L_SPM5020
MP1584-3V3: MP1584-B
MP1584-5V: MP1584; MP1584-B
MS1, MS2: CONNECT_3
NRF24LO1: NRF24L01_ML01SP4
R1, R4: 100k; R0603
R2, R5, R8, R10: 10k; R0603
R3: 31k6; R0603
R6: 53k6; R0603
R7, R11, R12, R13, R14, R15, R16: 2k; R0603
R9: 100R; R0603
ROTATE1, ROTATE2: CONNECT_3
S1: SS_12D11
SW: CONNECT_3
U$1: Плата питания; LOGO
U$2, U$5: MP2225; TSOT23-8
U$3, U$8, U$10: PBS_SMD_X13; PBD_SMD_X13
U$4: Плата радио; LOGO
U$6: L_3.3MKH; L_SPM5020
U$7: PBS_SMD_X9
U$9: STEP_MOT; JST-4-2.5
U$14: BLUETOOTH; 53047-04
X1: PERE; JST-2-2.5
X2: AKKUM; JST-2-2.5
XQ-02A: XQ-02A

Connections:
3V1: GPS-NEO7M.P$1, NRF24LO1.P$1, ROTATE1.1, ROTATE2.1, U$3.13, U$8.1
3V3: 74HC595.10, 74HC595.16, C5.1, C6.2, C7.2, DRIVER.P10, LIS3MDL.UCC, LSM6DS3.P$2, L_3.3.P$1, MP1584-3V3.P$7, MP1584-3V3.P$8, MS1.1, MS2.1, R3.2, R7.1, R8.2, R12.2, U$10.13
5V: C12.1, C13.2, C14.2, DRIVER.P$16, MP1584-5V.P$7, MP1584-5V.P$8, R6.2, R11.2, U$6.P$1, U$10.11, U$14.1
5V1: C15.2, C16.P$1, R15.1, U$3.11, U$8.3, XQ-02A.5V
A1: DRIVER.P$13, U$9.1
A2: DRIVER.P$14, U$9.3
ADC_FOTO: U$3.10, U$8.4
ANT_RADIO: J2.3, XQ-02A.ANT
B1: DRIVER.P$12, U$9.2
B2: DRIVER.P$11, U$9.4
BUS+: C2.2, C3.2, C9.2, C10.2, MP1584-3V3.P$1, MP1584-3V3.P$2, MP1584-5V.P$1, MP1584-5V.P$2, R1.1, R4.1, S1.2, U$2.P$2, U$5.P$2, X1.1
BUS+_OUT: S1.3, X2.1
CE_RADIO: NRF24LO1.P$2, U$7.1
CS_LIS: 74HC595.2, LIS3MDL.CS
CS_LSM: 74HC595.6, LSM6DS3.P$6
CS_RADIO: NRF24LO1.P$3, U$7.2
DIR_DRIVER: DRIVER.P$1, U$10.2
DIR_DRIVER1: U$3.2, U$8.12
EN_DRIVER: 74HC595.7, DRIVER.P$8
FOTO: FOTO.P$2, R7.2, U$10.10
GND: 3V3.C, 5V.C, 74HC595.8, C1.1, C2.1, C3.1, C6.1, C7.1, C8.1, C9.1, C10.1, C13.1, C14.1, DRIVER.P$9, DRIVER.P$15, FOTO.P$1, IRF7905.7, IRF7905.8, LIS3MDL.GND, LSM6DS3.P$3, MP1584-3V3.P$3, MP1584-3V3.P$4, MP1584-3V3.P$5, MP1584-3V3.P$6, MP1584-5V.P$3, MP1584-5V.P$4, MP1584-5V.P$5, MP1584-5V.P$6, MS1.3, MS2.3, R2.2, R5.2, R10.1, U$2.P$1, U$2.P$4, U$5.P$1, U$5.P$4, U$10.12, U$14.2, X2.2
GND1: C15.1, C16.P$2, GPS-NEO7M.P$4, J1.1, J1.2, J2.1, J2.2, NRF24LO1.P$8, R16.1, ROTATE1.3, ROTATE2.3, U$3.12, U$8.2, XQ-02A.GND, XQ-02A.GND1, XQ-02A.GND2, XQ-02A.GND3, XQ-02A.GND4, XQ-02A.GND5
IRQ_RADIO: NRF24LO1.P$7, U$7.3
LATCH_SR: 74HC595.12, U$10.5
LATCH_SR1: U$3.5, U$8.9
MISO_RADIO: NRF24LO1.P$6, U$7.5
MISO_SR: LIS3MDL.SDO, LSM6DS3.P$7, U$10.8
MISO_SR1: U$3.8, U$8.6
MOSI_RADIO: NRF24LO1.P$5, U$7.4
MOSI_SR: 74HC595.14, LIS3MDL.SDA, LSM6DS3.P$5, U$10.9
MOSI_SR1: U$3.9, U$8.5
MS1: DRIVER.P$7, MS1.2
MS2: DRIVER.P$6, MS2.2
unnamed: C1.2, U$2.P$7
unnamed: R1.2, U$2.P$6
unnamed: C4.2, U$2.P$5
unnamed: C4.1, L_3.3.P$2, U$2.P$3
unnamed: C5.2, R2.1, R3.1, U$2.P$8
unnamed: IRF7905.2, R9.1, R10.2
unnamed: C8.2, U$5.P$7
unnamed: R4.2, U$5.P$6
unnamed: C11.2, U$5.P$5
unnamed: C11.1, U$5.P$3, U$6.P$2
unnamed: C12.2, R5.1, R6.1, U$5.P$8
unnamed: 5V.A, R11.1
unnamed: 3V3.A, R12.1
unnamed: LED1.C, R13.2
unnamed: LED2.C, R14.2
unnamed: LED1.A, ROTATE1.2
unnamed: LED2.A, ROTATE2.2
unnamed: R14.1, XQ-02A.LED2
unnamed: R13.1, XQ-02A.LED1
unnamed: R15.2, SW.1
unnamed: R16.2, SW.3
OE_SR: 74HC595.13, R8.1, U$10.6
OE_SR1: U$3.6, U$8.8
PERE: 74HC595.1, R9.2
PERE_G: IRF7905.1, X1.2
RF-IN: J1.3, XQ-02A.RF-IN
RX1_BLE: U$10.4, U$14.3
RX1_BLE1: U$3.4, U$8.10
RX2_GPS: GPS-NEO7M.P$3, U$7.8
SCK_RADIO: NRF24LO1.P$4, U$7.6
SCK_SR: 74HC595.11, LIS3MDL.SCL, LSM6DS3.P$4, U$10.7
SCK_SR1: U$3.7, U$8.7
STEP_DRIVER: DRIVER.P$2, U$10.1
STEP_DRIVER1: U$3.1, U$8.13
SW: SW.2, XQ-02A.SW
TX1_BLE: U$10.3, U$14.4
TX1_BLE1: U$3.3, U$8.11
TX2_GPS: GPS-NEO7M.P$2, U$7.7
