cansat-tsniimash/NeonBlade-2024/src/board/NeoN_BlVdE/Core/Inc/main.h

#define LSM_CS_Pin GPIO_PIN_13
#define LSM_CS_GPIO_Port GPIOC
#define USILITEL_Pin GPIO_PIN_0
#define USILITEL_GPIO_Port GPIOA
#define LIS_CS_Pin GPIO_PIN_4
#define LIS_CS_GPIO_Port GPIOA
#define NRF_CE_Pin GPIO_PIN_1
#define NRF_CE_GPIO_Port GPIOB
#define NRF_CS_Pin GPIO_PIN_2
#define NRF_CS_GPIO_Port GPIOB
#define CS_TDC_Pin GPIO_PIN_10
#define CS_TDC_GPIO_Port GPIOB
