cansat-tsniimash/NeonBlade-2024/src/board/NeoN_BlVdE/Application/freakheader.h

/*
 * freakheader.h
 *
 *  Created on: 1 апр. 2023 г.
 *      Author: immm5
 */

#ifndef FREAKHEADER_H_
#define FREAKHEADER_H_


typedef struct
{
	double pressure;
	double bme_pres_grow;
	uint32_t time_steady;
	double temperature;
	double humidity;
	double altitude;

}bme_important_shit;




#endif /* FREAKHEADER_H_ */
