cansat-tsniimash/NeonBlade-2024/src/board/NeoN_BlVdE/Application/includes.h

#ifndef INCLUDES_H_
#define INCLUDES_H_

#include <stdint.h>
#include <stdbool.h>
#include <stdio.h>
#include <string.h>
#include <stm32f4xx_hal.h>
//#include <fatfs.h>

//#include <DWT_Delay/dwt_delay.h>
#include <stm32f4/Shift_Register/shift_reg.h>
//#include <BME280/DriverForBME280.h>
#include <stm32f4/LSM6DS3/DLSM.h>
#include <stm32f4/LIS3MDL/DLIS3.h>
#include <stm32f4/ATGM336H/nmea_gps.h>
//#include <1Wire_DS18B20/one_wire.h>
//#include <Dosimeter/dosimeter.h>
#include <../../Drivers/BME280_I2C/bme280.h>

#include <stm32f4/nRF24L01_PL/nrf24_upper_api.h>
#include <stm32f4/nRF24L01_PL/nrf24_lower_api.h>
#include <stm32f4/nRF24L01_PL/nrf24_lower_api_stm32.h>
#include <stm32f4/nRF24L01_PL/nrf24_defs.h>

#endif /* INCLUDES_H_ */
