cansat-tsniimash/NeonBlade-2024/(commit log)

2023-11-04 поправил
2023-11-24 Создал папочки в репозитории
2023-11-25 Удалил временно файл
2023-11-25 Вернул файл
2023-11-25 Сборка нижнего модуля.
2023-11-25 Сборка нижнего модуля. (поправил)
2023-11-29 Добавил вырезы на плате. Исправил версии моделей
    [lens1.prt, lens2.prt, lensholder.prt, lensholder2.prt, li-ion-cell_icr18650-1400.prt, low_module_carcas-v2.prt, low_module_plate.prt, low_module_prt1.prt]
2023-11-29 Модели плат
2023-11-29 Модели плат(очистил старые версии)
    [board_high.prt, board_middle.prt, dc_dc.prt, gps_ublox_neo-7m-0-000.prt, gy-lsm6ds3_lsm6ds3.prt, magnetometer_lis3mdl.prt, microsd_connector_502774-0891.prt, nrf24l01_pa_lna_e01_ml01sp4.prt]
2023-11-29 в 100500 раз поменял плату
    [Down_Main_Board .sch, Down_Main_Board.brd, UP_Main_Board.sch, Up_Main_Board.brd]
2023-12-01 Пишем драйвер TDC-GP21. Определили регистры и команды
2023-12-01 100501 раз изменил пины на плате
    [Down_Main_Board .sch, Down_Main_Board.brd, UP_Main_Board.sch, Up_Main_Board.brd]
2023-12-01 Сборка нижнего модуля с платами
    [board_high.prt, board_middle.prt, connector-pbs.prt, dc_dc.prt, gpstwo.prt, gy-lsm6ds3_lsm6ds3.prt, lens1.prt, lens2.prt]
2023-12-02 Развод на плате...
    [UP_Main_Board.sch, Up_Main_Board.brd]
2023-12-02 поменял гпс на верхней плате
    [UP_Main_Board.sch, Up_Main_Board.brd]
2023-12-13 какая то плата
    [lidar_made_by_apple.brd, lidar_made_by_apple.sch]
2023-12-15 спонсор страданий
    [UP_Main_Board.sch, Up_Main_Board.brd, lidar_made_by_apple.brd, lidar_made_by_apple.sch]
2023-12-15 Down_плата
    [Down_Main_Board .brd]
2023-12-16 переделал плату лидара
    [lidar_made_by_apple.brd, lidar_made_by_apple.sch]
2023-12-16 добавил элементы стабилизации
    [kamushkin.prt, lens2.prt, lensholder2.prt, low_module_carcas-v2.prt, low_module_prt1.prt, reika.prt, shadowraze.prt, spring_0_8x4x9turns.prt]
2023-12-16 Добавил гитигнор в scematic
2023-12-17 я сделял
    [lidar_made_by_apple.brd]
2023-12-22 немного переделал плату лидара
    [lidar_made_by_apple.brd, lidar_made_by_apple.sch]
2023-12-22 ага угу
    [lidar_made_by_apple.brd, lidar_made_by_apple.sch]
2023-12-23 Безумие — это точное повторение одного и того же действия раз за разом в надежде на изменение
    [lidar_made_by_apple.brd, lidar_made_by_apple.sch]
2023-12-23 Даниил на протяжении 510 лет переделывает плату лидара
    [lidar_made_by_apple.brd, lidar_made_by_apple.sch]
2023-12-29 внес изменения в модель аппарата
    [connector_pbs-smd.prt, low_module_carcas-v2.prt, pinhead_smd_female.prt, pinhead_smd_male.prt, reika.prt, shadowraze.prt, stabilizator.prt, stergni.prt]
2023-12-29 почти добавил новый разъём
    [Down_Main_Board .brd, Down_Main_Board .sch, UP_Main_Board.sch, Up_Main_Board.brd, lidar_made_by_apple.brd, lidar_made_by_apple.sch]
2024-01-03 Добавил в папку с аппаратом потерявшиеся модели
    [holder_for_jew.prt, motor-reductor.prt]
2024-01-03 Добавил крышку для парашютного отсека.
    [parachutecap.prt]
2024-01-03 Добавил еще одну потеряшку
    [jew.prt]
2024-01-04 Добавили массы моделям, теперь они качки как рома
    [board_high.prt, board_middle.prt, holder_for_jew.prt, jew.prt, lens1.prt, lens2.prt, lensholder.prt, lensholder2.prt]
2024-01-04 Добавил в сборку пружины и нить.
    [parachutecap.prt, reika.prt, rope.prt, shadowraze.prt, spring_0_8x4x9turns.prt, stabilizator.prt, stergni.prt]
2024-01-07 Завершен механизм раскрытия парашюта
    [axe.prt, holder_for_jew.prt, jew.prt, li-ion-cell_icr18650-1400.prt, low_module_prt1.prt, motor-reductor.prt, parachutecap.prt, parashute_platform.prt]
2024-01-10 Исправленная модель аппарата
    [axe.prt, key.prt, stabilizator.prt]
2024-01-20 переделки по плате
    [Down_Main_Board .brd, Down_Main_Board .sch, UP_Main_Board.sch, Up_Main_Board.brd, lidar_made_by_apple.brd, lidar_made_by_apple.sch]
2024-01-24 Модель исправлена, сделан габаритный чертёж.
2024-02-01 Переименовал файлы модели.Выгрузил упрощенную модель. Завершил ГЧ
    [axe.prt, bass_buzzer.prt, board-bottom.prt, board-lidar.prt, board-top.prt, board_high.prt, board_middle.prt, buzzer.prt]
2024-02-01 Забыл добавить две модельки
    [fotorez.prt, gps_antenna.prt]
2024-02-01 Выложил документы на зимнюю сессию в ЛС и сюда
2024-02-01 Плюс презентация
2024-02-02 ПЕРЕДЕЛАЙ ПАЛТЫ
    [Down_Main_Board .brd, UP_Main_Board.sch, Up_Main_Board.brd, lidar_made_by_apple.brd]
2024-02-03 исправил верхнюю плату
    [Down_Main_Board .brd, Up_Main_Board.brd]
2024-02-03 передвинул пинхеадер и поменял значения резисторов
    [lidar_made_by_apple.brd, lidar_made_by_apple.sch]
2024-02-03 чёт сделял
    [lidar_made_by_apple.brd, lidar_made_by_apple.sch]
2024-02-03 опять чёт сделял
    [lidar_made_by_apple.brd, lidar_made_by_apple.sch]
2024-02-03 Исправили форму печатных плат
    [board-bottom.prt, board-lidar.prt, connector_pbs-smd.prt, stabilizator.prt, switch_ss-12d11.prt]
2024-02-03 Выгрузили DXF печатных плат
    [board_bottom.dxf, plata-lidarna.dxf, plata_verx.dxf]
2024-02-07 дбвл бблтк
2024-02-07 поправил контур всех плат
    [Down_Main_Board .brd, Up_Main_Board.brd, lidar_made_by_apple.brd]
2024-02-07 откатили плату назад
    [Down_Main_Board .brd]
2024-02-09 Почти доделал нижнюю плату
    [Down_Main_Board .brd, Down_Main_Board .sch]
2024-02-09 чипи чипи чапа чапа дуби дуби
    [UP_Main_Board.sch, Up_Main_Board.brd, lidar_made_by_apple.brd, lidar_made_by_apple.sch]
2024-02-10 Ошибка повторенная дважды называется - выбор
    [lidar_made_by_apple.brd, lidar_made_by_apple.sch]
2024-02-14 пределал плату лидара х6
    [lidar_made_by_apple.brd, lidar_made_by_apple.sch]
2024-02-21 Написан парсер пакетов для наземки на RPi
2024-02-21 добавил полигоны на плату и добавил буквы на разъём
    [UP_Main_Board.sch, Up_Main_Board.brd, lidar_made_by_apple.brd, lidar_made_by_apple.sch]
2024-02-21 Перенес код для RPi наземки
2024-02-21 Пробуем работать с Ctypes для наземки
2024-02-21 Выгружаем бортовой код
2024-02-21 какие-то файлы наземки затерялись
2024-02-21 Перевернул GPS. Теперь надо переразвести
    [UP_Main_Board.sch, Up_Main_Board.brd]
2024-02-23 культивировал плату
    [Up_Main_Board.brd]
2024-02-23 забыли моторчик...
    [UP_Main_Board.sch, Up_Main_Board.brd]
2024-02-24 забыи отладочные пины...
    [UP_Main_Board.sch, Up_Main_Board.brd, lidar_made_by_apple.brd, lidar_made_by_apple.sch]
2024-02-24 Проверил плату нижнюю
    [Down_Main_Board .brd, Down_Main_Board .sch]
2024-02-25 Проверил плату верхнюю. Осталось только убрать у GPS отверстие под антенну, чтобы оно не мешало полигону земли
    [UP_Main_Board.sch, Up_Main_Board.brd]
2024-02-29 Наконец-то выгрузил описание проекта плат
2024-02-29 Внес поправки
    [Down_Main_Board .brd, Down_Main_Board .sch, Up_Main_Board.brd]
2024-03-01 Убрал дырку и 100501 раз изменил плату лидара
    [UP_Main_Board.sch, Up_Main_Board.brd, lidar_made_by_apple.brd, lidar_made_by_apple.sch]
2024-03-04 Считаем, что платы готовы к производству
    [Down_Main_Board .brd, lidar_made_by_apple.brd, lidar_made_by_apple.sch]
2024-03-04 теперь точно готовы
    [Down_Main_Board .brd, Up_Main_Board.brd, board-bottom.dxf, board-lidar.dxf, board-top.dxf, lidar_made_by_apple.brd]
2024-03-04 Сделал заказ плат в Резоните
    [Cansat-2024-1.brd, Cansat-2024-2.brd]
2024-03-06 Наземка от Ивана
2024-03-08 Добавил пз
2024-03-08 изменил пзпзпзппз
2024-03-10 План-график с марта
    [План-график (Март+).xlsx]
2024-03-13 Добавлен график
2024-03-15 Готовим модели для печати
    [antena_gabena.prt, axe.prt, board-bottom.prt, board-lidar.prt, board-top.prt, buzzer.prt, connector-pbs.prt, connector_b2b-eh-a.prt]
2024-03-15 Создаем макет для сбросов
    [axe.prt, mockup_banka.prt, parachute-cap.prt, parashute-korpus.prt, parashute-platform.prt, real_banka.prt, spring.prt, spring_0_8x4x9turns.prt]
2024-03-16 графики везде и цифорки добавил
2024-03-16 Добавил кривых на график с ускорением
2024-03-16 мейк ап для мок ап (вроде сделал макет для сбросов)
    [mockup_banka.prt, mockup_banka.stl]
2024-03-20 Добавил примитивное отображение ориентации
    [test3dmesh.stl]
2024-03-20 Добавил нашу упрощённую модель
    [Sat_Simple2.stl, sat_simple.stl]
2024-03-22 Немного оптимизации
2024-03-23 добавлен 3д график лидара
2024-03-23 последняя рабочая версия
2024-03-23 теперь эта последняя
2024-04-19 передал обезьяне все модели аппарата
    [incinerator-korpus.prt, korpus-botom.prt, korpus-top.prt, kranshtein.prt, parachute-cap.prt, parashute-korpus.prt, parashute-platform.prt, protective-tip-big.prt]
2024-04-20 переделал плату лидара(((((
    [lidar_made_by_apple.brd, lidar_made_by_apple.sch]
2024-04-20 ещё раз(((((((((((((((((((((((((((((((((((((
    [lidar_made_by_apple.brd, lidar_made_by_apple.sch]
2024-04-20 ещё и библеотеку скинул
2024-04-24 наземка
2024-04-24 новые держатели линз
2024-05-05 этого ни кто не видел
    [lidar_made_by_apple.brd]
2024-05-08 последняя работающая версия наземки
    [kranshtein.stl]
2024-05-11 Выгрузили STL файлы для печати
    [incinerator-korpus.stl, korpus-botom.stl, korpus-top.stl, mirrorholder1.stl, mirrorholder2.stl, parachute-cap.stl, parashute-korpus.stl, parashute-platform.stl]
2024-05-11 Обновили модель для спецификации
    [lenshildersmallprt2.prt, lensholderbig.prt, lensholderbigprt2.prt, lensholdersmall.prt, vint_g11738_2.prt]
2024-05-12 Заказана плата лидара v2
    [lidar_made_by_apple.brd]
2024-06-15 Последняя версия наземки
